Djgreene730/Ad-Flier/altium/images/Flight_Controller_Bottom_Top.png

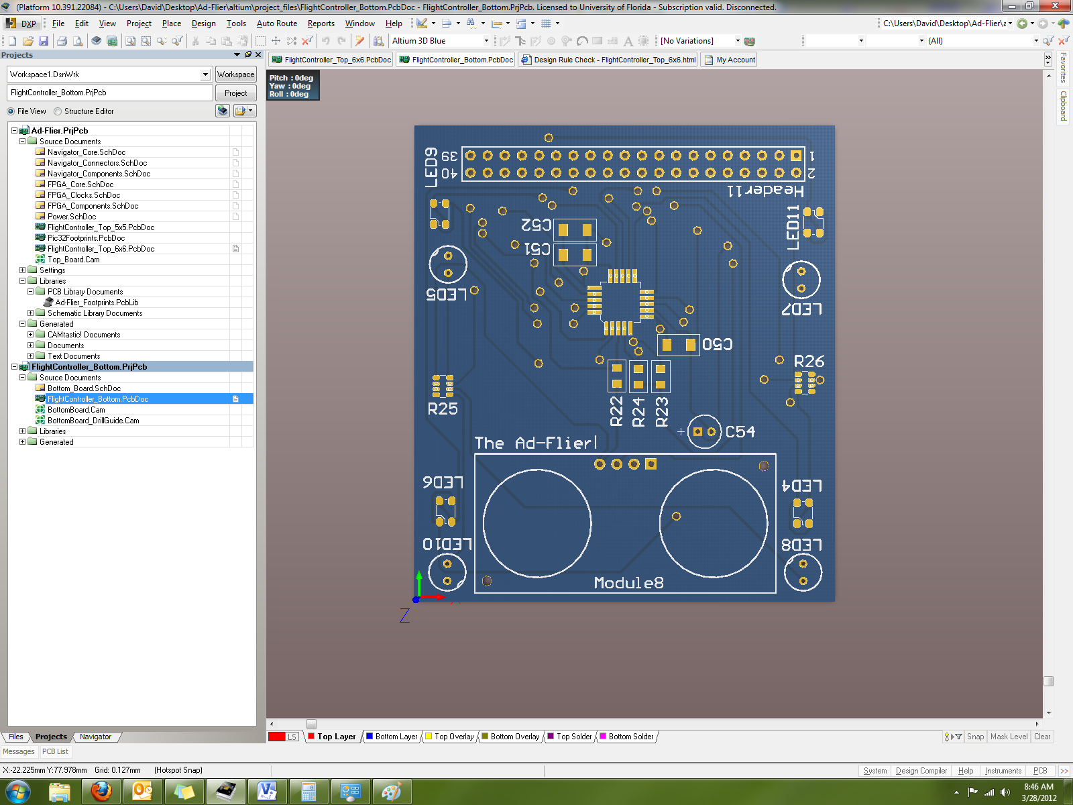
altium/images/Flight_Controller_Bottom_Top.png
