Djgreene730/Ad-Flier/altium/images/Flight_Controller_Top_Top.png

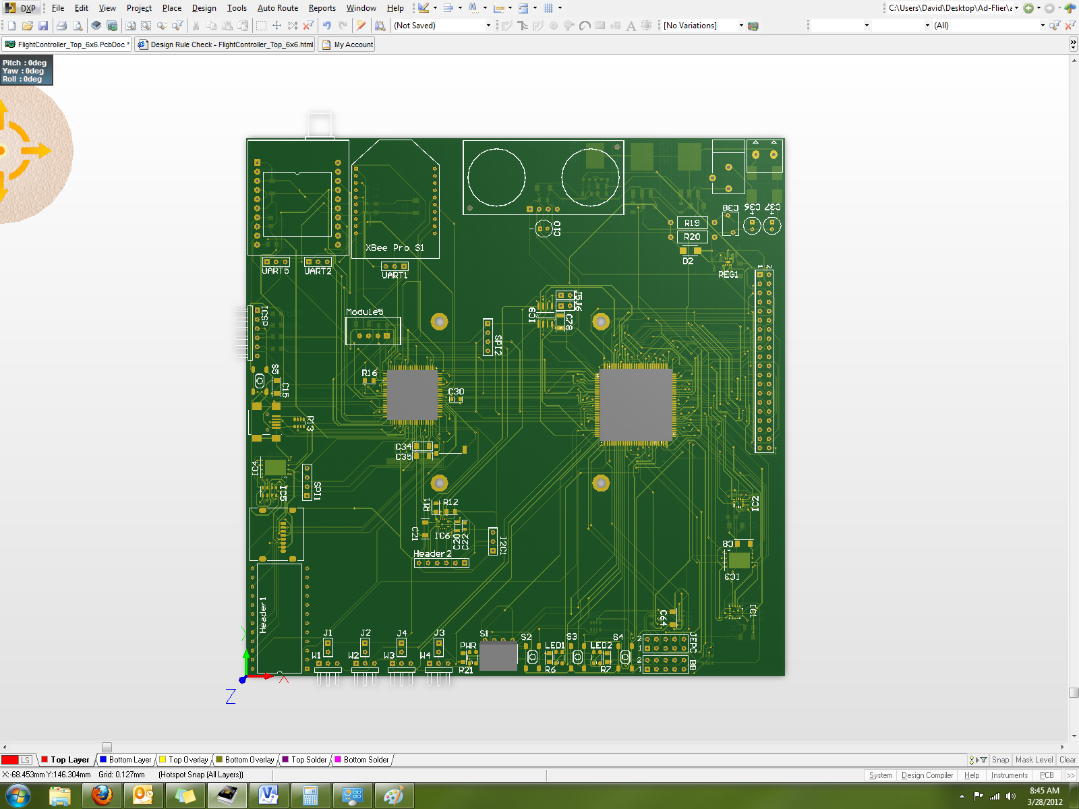
altium/images/Flight_Controller_Top_Top.png
