Djgreene730/Ad-Flier/flowcharts/README

Project: 	Ad-Flier / 
Description:	PIC32 & CycloneII Based Navigation and Stabalization board for UAV's.
Davte:		February 20th, 2012
Authors:	David Greene
		Sal D'Acunto
