Djgreene730/Ad-Flier/altium/README

Project: 	Ad-Flier / Altium Board Files
Description:	PIC32 & CycloneII Based Navigation and Stabalization board for UAV's.
Davte:		February 20th, 2012
Authors:	David Greene
		Sal D'Acunto
