Djgreene730/Ad-Flier/code_windows/README

Project: 	Ad-Flier / Code for the Windows Stats Panel and Interface
Description:	PIC32 & CycloneII Based Navigation and Stabalization board for UAV's.
Davte:		February 20th, 2012
Authors:	David Greene
		Sal D'Acunto
