Djgreene730/Ad-Flier/PIC32_FlightController.X/README

Project: 	Ad-Flier / Code for the PIC32 Flight Control Board
Description:	PIC32 & CycloneII Based Navigation and Stabalization board for UAV's.
Davte:		February 20th, 2012
Authors:	David Greene
		Sal D'Acunto
