Djgreene730/Ad-Flier/altium/images/Accelerometer.jpg

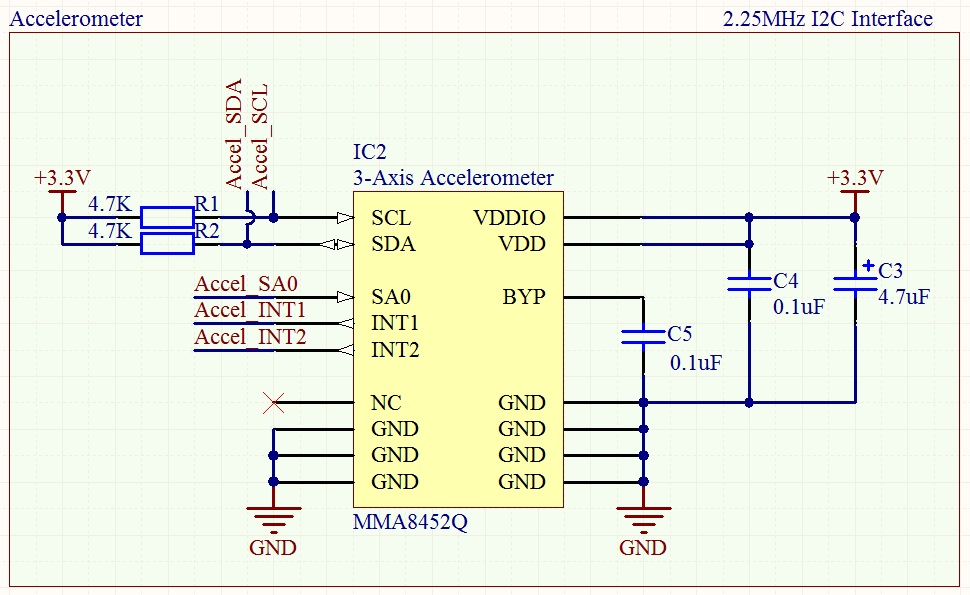
altium/images/Accelerometer.jpg
