Djgreene730/Ad-Flier/altium/images/Flight_Controller_Bottom_Bottom.png

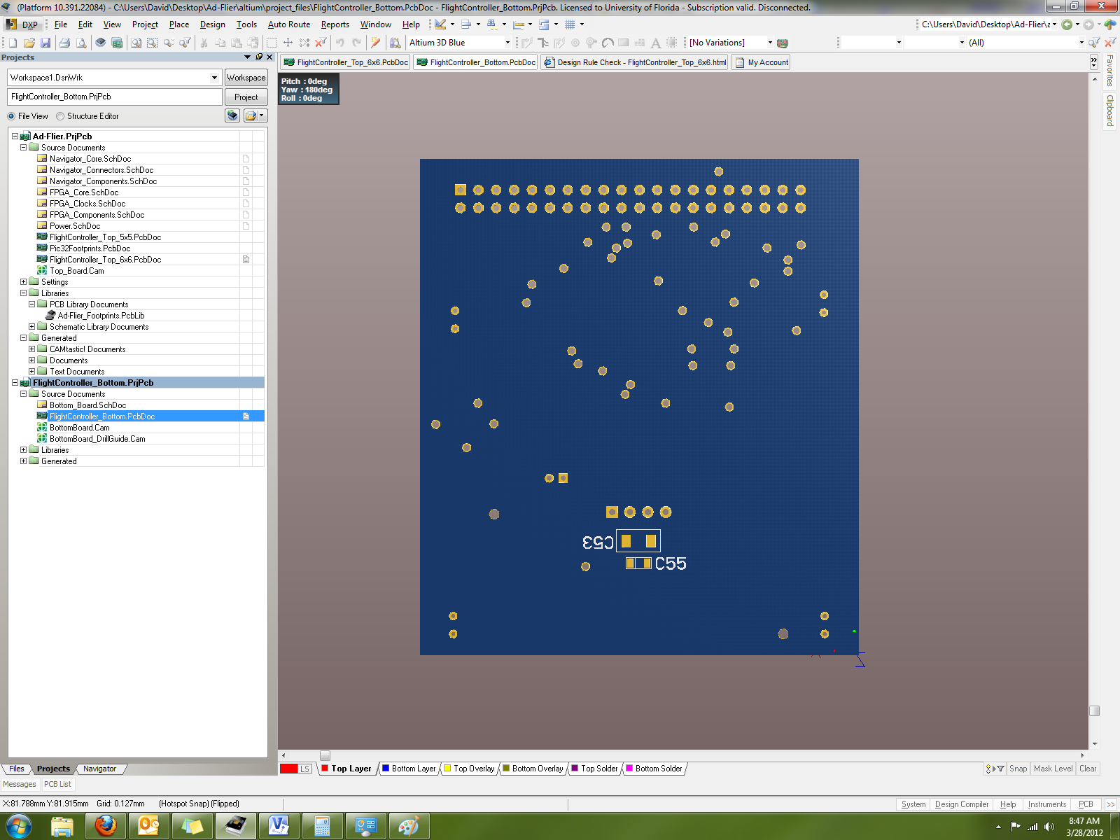
altium/images/Flight_Controller_Bottom_Bottom.png
