Djgreene730/Ad-Flier/altium/images/Flight_Controller_Top_Bottom.png

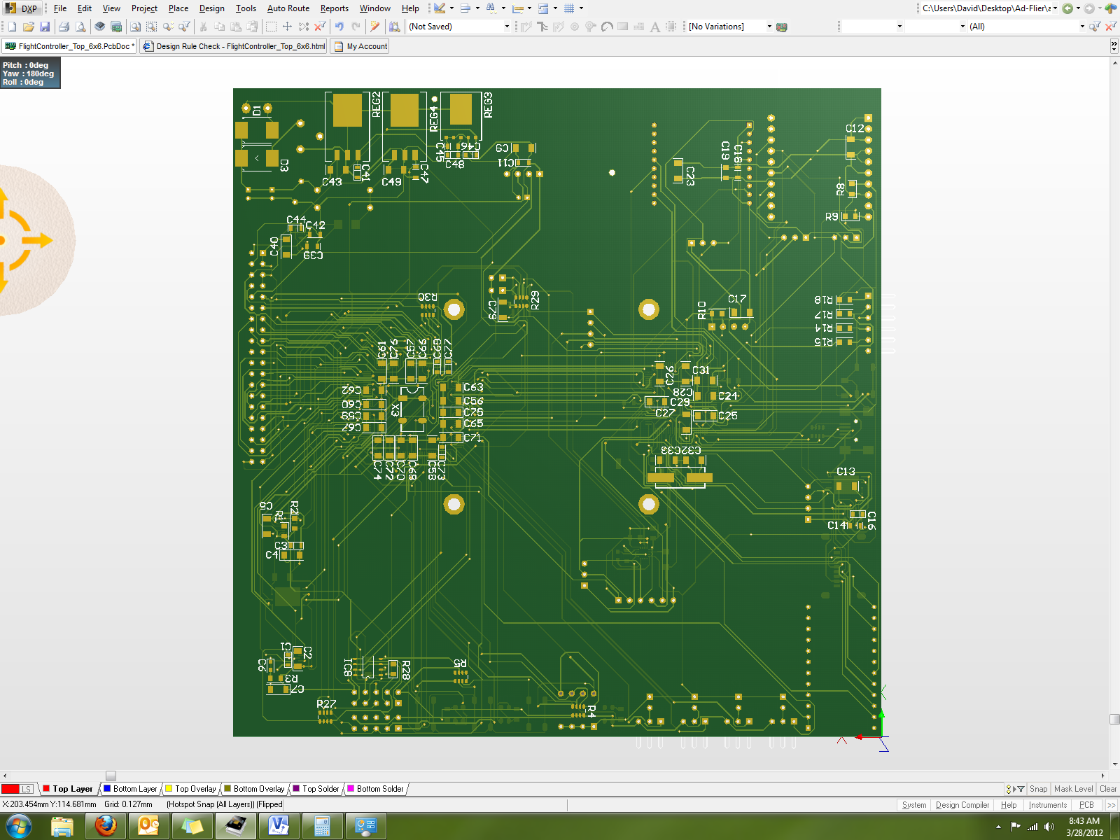
altium/images/Flight_Controller_Top_Bottom.png
