Djgreene730/Ad-Flier/altium/images/Gyroscope.jpg

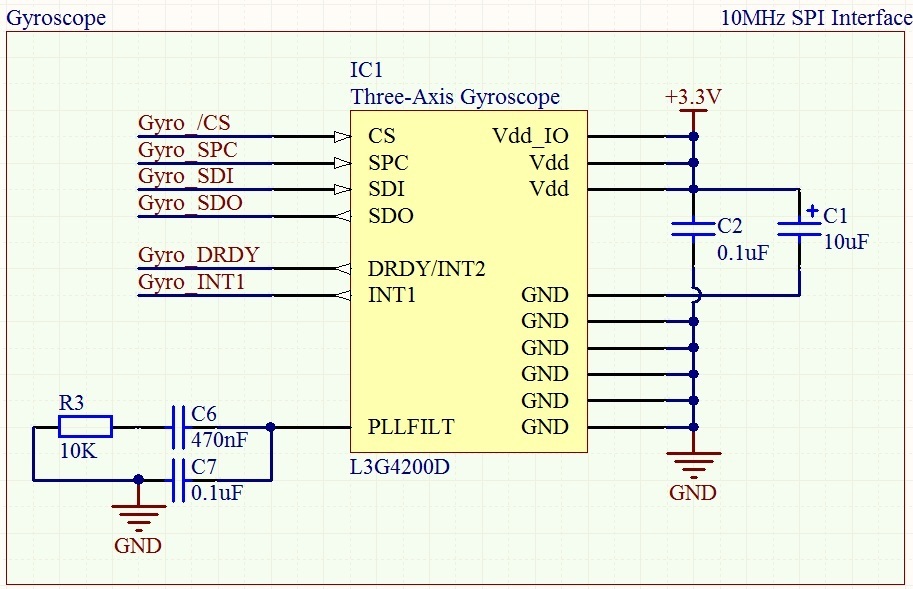
altium/images/Gyroscope.jpg
