Djgreene730/Ad-Flier/altium/project_files/Project Outputs for FlightController_Bottom/BOM_FlightController_Bottom.xlsx

Comment | Description | Designator | Footprint | LibRef | Quantity
0.1uF SMD 1206 | Capacitor | C50, C51, C52, C53 | SMD 1206 | Cap | 4
10uF Electrolitic | Polarized Capacitor (Radial) | C54 | CAPPR2-5x5 | Cap Pol1 | 1
1.0uF Low-ESR Tantalum CaseA | Tantalum Capacitor - Case A | C55 | Capacitor - Tantalum Case A | SMD_Cap_Tantalum | 1
Header 20X2H | Header, 20-Pin, Dual row, Right Angle | Header11 | HDR2X20H | Header 20X2H | 1
LED PLCC-4 | Surface Mount Chip LED | LED4, LED6, LED9, LED11 | PLCC-4 LED | HSMF-C157 | 4
LED Blue Through-Hole | Typical INFRARED GaAs LED | LED5, LED7, LED8, LED10 | Blue LED | LED0 | 4
TCM8230MD | Toshiba 640x480 Camera | Module7 | TCM8230MD Camera Module | TCM8230MD | 1
HC-SR04 Ultrasonic Module | HC-SR04 Ultrasonic Module | Module8 | HC-SR04 Ultrasonic Ranger | HC-SR04 Ultrasonic Module | 1
4.7K SMD 0805 | Resistor | R22, R23, R24 | SMD 0805 | Res2 | 3
Value: 10K SMD Resistor Array | 4-Count Resistor Array | R25, R26 | Resistor Array YC164 | SMD Resistor Array | 2
