Djgreene730/Ad-Flier/altium/project_files/BaseStation/Project Outputs for BaseStation/BaseStation.xlsx

Comment | Description | Designator | Footprint | LibRef | Quantity
Coin Cell Holder | Coin Cell Battery Holder | BATT1 | Coil Cell Holder | Coin Cell Holder | 1
0.1uF SMD 1206 | Capacitor | C1, C2, C3, C4, C5, C6, C8, C13, C15, C16, C23, C25, C27 | SMD 1206 | Cap | 13
10uF Low-ESR Tantalum CaseA | Tantalum Capacitor - Case A | C7, C14, C24, C26 | Capacitor - Tantalum Case A | SMD_Cap_Tantalum | 4
22pF SMD 1206 | Capacitor | C9, C10, C11, C12 | SMD 1206 | Cap | 4
1.0uF Low-ESR Tantalum CaseA | Tantalum Capacitor - Case A | C17, C19, C20, C21 | Capacitor - Tantalum Case A | SMD_Cap_Tantalum | 4
8.2pF SMD 0805 | Capacitor | C18 | SMD 0805 | Cap | 1
10uF Electrolitic | Polarized Capacitor (Radial) | C22 | CAPPR2-5x5 | Cap Pol1 | 1
MBRS540T3G | 40V 5A Scottky Diode | D1, D3 | MBRS540T3G | MBRS540T3G | 2
1SMAS913BT3G | 3.3V 1.5W Zener Diode | D2 | 1SMA5913BT3G | 1SMAS913BT3G | 1
SPI1 | Header, 4-Pin | Debug1, Debug2 | HDR1X4 | Header 4 | 2
UART1 | Header, 3-Pin | Debug3 | HDR1X3 | Header 3 | 1
UART2 | Header, 3-Pin | Debug4 | HDR1X3 | Header 3 | 1
UART5 | Header, 3-Pin | Debug5 | HDR1X3 | Header 3 | 1
Battery |  | H1 | PC Wire Connector | PC Wire Connector | 1
7-12V | DC Power Jack | H2 | DC Power Jack | DC Jack | 1
ICSP | Header, 6-Pin | Header 1 | HDR1X6H | Header 6 | 1
PIC32MX795F512L-80I/PT | High Performance 80 MHz MIPS-Based 32-Bit Flash Microcontroller with USB, CAN and Ethernet, 512KB Program Memory, 100-pin TQFP, Industrial Temperature | IC1 | TQFP-PF100_L | PIC32MX795F512L-80I/PT | 1
MPL115A1 | Miniature SPI Digital Barometer | IC2 | MPL115A1 | MPL115A1 | 1
GPS Select | Header, 4-Pin, Dual row | J1 | HDR2X4 | Header 4X2 | 1
Link |  | LED1 | PLCC-4 LED | SMD LED | 1
ON | Surface Mount Chip LED | LED2 | PLCC-4 LED | SMD LED | 1
Mini-USB | Mini-USB | Module1 | Mini B USB Connector | Mini USB Connector | 1
Trimble 37824-B | Trimble 37824-B GPS Module | Module2 | Trimble 37824-B | Trimble 37824-B | 1
Bluetooth | Bluetooth SMD Serial Module | Module3 | BT0417C Bluetooth Module | Bluetooth SMD Module | 1
XBee Pro S1 | XBee Pro S1 60mW Wireless Module | Module4 | XBee Pro S1 Wireless Module | XBee Pro S1 | 1
MicroSD | MicroSD SPI Interface | Module5 | MicroSD Card Slot | MicroSD Socket | 1
PS2 Controller | PS2 Wireless Controller | Module6 | PS2 Wireless Module | PS2 Wireless Controller | 1
Header 2 | Header, 2-Pin | P1, P2, P3 | HDR1X2 | Header 2 | 3
10 SMD 0805 | Resistor | R1 | SMD 0805 | Res2 | 1
10K SMD 0805 | Resistor | R2, R7, R8, R9 | SMD 0805 | Res2 | 4
100 SMD 0805 | Resistor | R3, R5, R6 | SMD 0805 | Res2 | 3
Value: 10K SMD Resistor Array | 4-Count Resistor Array | R4, RA1 | Resistor Array YC164 | SMD Resistor Array | 2
1K SMD 0805 | Resistor | R10, R11, R14 | SMD 0805 | Res2 | 3
3.9K Radial | Resistor | R12 | RES12.2-8.5X3.3 | Res2 | 1
1.3K Radial | Resistor | R13 | RES12.2-8.5X3.3 | Res2 | 1
MIC29300-5.0WU | 3.0A LDO Fixed Volt.(ROHS Compliant) | REG1 | TO-263 D2PACK | MIC29300-5.0WU | 1
MIC29300-3.3WU | 3.0A LDO Fixed Volt.(ROHS Compliant) | REG2 | TO-263 D2PACK | MIC29300-3.3WU | 1
Reset | SMD Tactile Switch | S1 | SMD Tactile Switch | SMD Tactile Switch | 1
Key | SMD Tactile Switch | S2 | SMD Tactile Switch | SMD Tactile Switch | 1
XT9M20ANA8M | 8MHz SMD Crystal | X1 | XT9M20ANA8M - 8MHz Capacitor | XT9M20ANA8M | 1
SSP-T6-7PF-20PPM | 32.768KHz 7pF SMD Crystal | X2 | 32.768KHz Crystal | SSP-T6-7PF-20PPM | 1
