Djgreene730/Ad-Flier/code_cyclone2/BoardTest/BoardTest/TestSPI/TestSPI.html

TestSPI | TestSPI 1.0

2012.04.14.18:18:51 | Generation Report

Output Directory | C:/Users/David/GitHub/Ad-Flier/code_cyclone2/BoardTest/TestSPI/

Files

C:/Users/David/GitHub/Ad-Flier/code_cyclone2/BoardTest/TestSPI/synthesis/TestSPI.v (2964 bytes VERILOG)

C:/Users/David/GitHub/Ad-Flier/code_cyclone2/BoardTest/TestSPI/synthesis/submodules/TestSPI_spi_0.v (12263 bytes VERILOG)
C:/Users/David/GitHub/Ad-Flier/code_cyclone2/BoardTest/TestSPI/synthesis/submodules/altera_reset_controller.v (3595 bytes VERILOG)
C:/Users/David/GitHub/Ad-Flier/code_cyclone2/BoardTest/TestSPI/synthesis/submodules/altera_reset_synchronizer.v (3564 bytes VERILOG)
C:/Users/David/GitHub/Ad-Flier/code_cyclone2/BoardTest/TestSPI/synthesis/submodules/altera_reset_controller.sdc (1179 bytes SDC)
Instantiations

TestSPI TestSPI v1.0 | TestSPI_spi_0 as spi_0 altera_reset_controller as rst_controller
TestSPI_spi_0 altera_avalon_spi v11.1
altera_reset_controller altera_reset_controller v11.1

Generation Messages

2012.04.14.18:16:35 [Warning] TestSPI.spi_0: spi_0.external must be exported, or connected to a matching conduit. 2012.04.14.18:16:35 [Warning] TestSPI.spi_0: spi_0.spi_control_port must be connected to an Avalon-MM master 2012.04.14.18:16:35 [Warning] TestSPI.spi_0: Interrupt sender spi_0.irq is not connected to an interrupt receiver 2012.04.14.18:16:35 [Info] TestSPI: Generating TestSPI "TestSPI" for QUARTUS_SYNTH 2012.04.14.18:16:35 [Debug] TestSPI: queue size: 0 starting:TestSPI "TestSPI" 2012.04.14.18:16:36 [Debug] Transform: PipelineBridgeSwap 2012.04.14.18:16:36 [Info] pipeline_bridge_swap_transform: After transform: 2 modules, 2 connections 2012.04.14.18:16:36 [Debug] Transform: ClockCrossingBridgeSwap 2012.04.14.18:16:36 [Debug] Transform: QsysBetaIPSwap 2012.04.14.18:16:36 [Debug] Transform: CustomInstructionTransform 2012.04.14.18:16:36 [Info] No custom instruction connections, skipping transform 2012.04.14.18:16:36 [Debug] Transform: TristateConduitUpgradeTransform 2012.04.14.18:16:36 [Debug] Transform: TranslatorTransform 2012.04.14.18:16:36 [Info] No Avalon connections, skipping transform 2012.04.14.18:16:36 [Debug] Transform: DomainTransform 2012.04.14.18:16:36 [Debug] Transform: RouterTransform 2012.04.14.18:16:36 [Debug] Transform: TrafficLimiterTransform 2012.04.14.18:16:36 [Debug] Transform: BurstTransform 2012.04.14.18:16:36 [Debug] Transform: ResetAdaptation 2012.04.14.18:16:36 [Progress] min: 0 2012.04.14.18:16:36 [Progress] max: 1 2012.04.14.18:16:36 [Progress] current: 1 2012.04.14.18:16:36 [Info] reset_adaptation_transform: After transform: 3 modules, 4 connections 2012.04.14.18:16:36 [Debug] Transform: NetworkToSwitchTransform 2012.04.14.18:16:36 [Debug] Transform: WidthTransform 2012.04.14.18:16:36 [Debug] Transform: RouterTableTransform 2012.04.14.18:16:36 [Debug] Transform: ClockCrossingTransform 2012.04.14.18:16:36 [Debug] Transform: PipelineTransform 2012.04.14.18:16:36 [Debug] Transform: TrafficLimiterUpdateTransform 2012.04.14.18:16:36 [Debug] Transform: InterruptMapperTransform 2012.04.14.18:16:36 [Debug] Transform: InterruptSyncTransform 2012.04.14.18:16:36 [Debug] Transform: InterruptFanoutTransform 2012.04.14.18:16:36 [Debug] TestSPI: "TestSPI" reuses altera_avalon_spi "submodules/TestSPI_spi_0" 2012.04.14.18:16:36 [Debug] TestSPI: "TestSPI" reuses altera_reset_controller "submodules/altera_reset_controller" 2012.04.14.18:16:37 [Debug] TestSPI: queue size: 1 starting:altera_avalon_spi "submodules/TestSPI_spi_0" 2012.04.14.18:16:38 [Info] Starting classic module elaboration. 2012.04.14.18:17:37 [Progress] "c:/altera/11.1sp1/quartus/bin/jre/bin/java.exe" -Xmx512M -classpath "c:/altera/11.1sp1/quartus/sopc_builder/bin/sopc_builder.jar;c:/altera/11.1sp1/quartus/sopc_builder/bin/PinAssigner.jar;c:/altera/11.1sp1/quartus/sopc_builder/bin/sopc_wizard.jar;c:/altera/11.1sp1/quartus/sopc_builder/bin/jptf.jar" sopc_builder.sopc_builder -d"c:/altera/11.1sp1/quartus/sopc_builder" -notalkback=1 -projectnameyysystem.qpf -projectpathC:/Users/David/AppData/Local/Temp/alt5444_3243432175891964107.dir/0001_sopclgen --no_splash --refresh C:/Users/David/AppData/Local/Temp/alt5444_3243432175891964107.dir/0001_sopclgen/yysystem.v --quartus_dir="c:/altera/11.1sp1/quartus" --sopc_perl="c:/altera/11.1sp1/quartus/bin/perl" --sopc_lib_path="++c:/altera/11.1sp1/quartus/../ip/altera/sopc_builder_ip+c:/altera/11.1sp1/quartus/../ip/altera/nios2_ip" 2012.04.14.18:17:44 [Info] Finished elaborating classic module. 2012.04.14.18:17:44 [Progress] Executing: C:/altera/11.1sp1/quartus//sopc_builder/bin/sopc_builder --classic --generate C:/Users/David/AppData/Local/Temp/alt5444_3243432175891964107.dir/0001_sopclgen/yysystem.ptf 2012.04.14.18:17:44 [Info] Running sopc_builder... 2012.04.14.18:18:41 [Progress] "c:/altera/11.1sp1/quartus/bin/jre/bin/java.exe" -Xmx512M -classpath "c:/altera/11.1sp1/quartus/sopc_builder/bin/sopc_builder.jar;c:/altera/11.1sp1/quartus/sopc_builder/bin/PinAssigner.jar;c:/altera/11.1sp1/quartus/sopc_builder/bin/sopc_wizard.jar;c:/altera/11.1sp1/quartus/sopc_builder/bin/jptf.jar" sopc_builder.sopc_builder -d"c:/altera/11.1sp1/quartus/sopc_builder" -notalkback=1 -projectnameyysystem.qpf -projectpathC:/Users/David/AppData/Local/Temp/alt5444_3243432175891964107.dir/0001_sopclgen --generate C:/Users/David/AppData/Local/Temp/alt5444_3243432175891964107.dir/0001_sopclgen/yysystem.v --quartus_dir="c:/altera/11.1sp1/quartus" --sopc_perl="c:/altera/11.1sp1/quartus/bin/perl" --sopc_lib_path="++c:/altera/11.1sp1/quartus/../ip/altera/sopc_builder_ip+c:/altera/11.1sp1/quartus/../ip/altera/nios2_ip" 2012.04.14.18:18:47 [Progress] No .sopc_builder configuration file(!) 2012.04.14.18:18:47 [Progress] . 2012.04.14.18:18:50 [Progress] # 2012.04.14 18:18:50 (*) Success: sopc_builder finished. 2012.04.14.18:18:51 [Info] spi_0: "TestSPI" instantiated altera_avalon_spi "spi_0" 2012.04.14.18:18:51 [Debug] TestSPI: queue size: 0 starting:altera_reset_controller "submodules/altera_reset_controller" 2012.04.14.18:18:51 [Info] rst_controller: "TestSPI" instantiated altera_reset_controller "rst_controller" 2012.04.14.18:18:51 [Info] TestSPI: Done TestSPI" with 3 modules, 5 files, 23565 bytes
