Djgreene730/Ad-Flier/flowcharts/Overview-InProgress.vsd.pdf

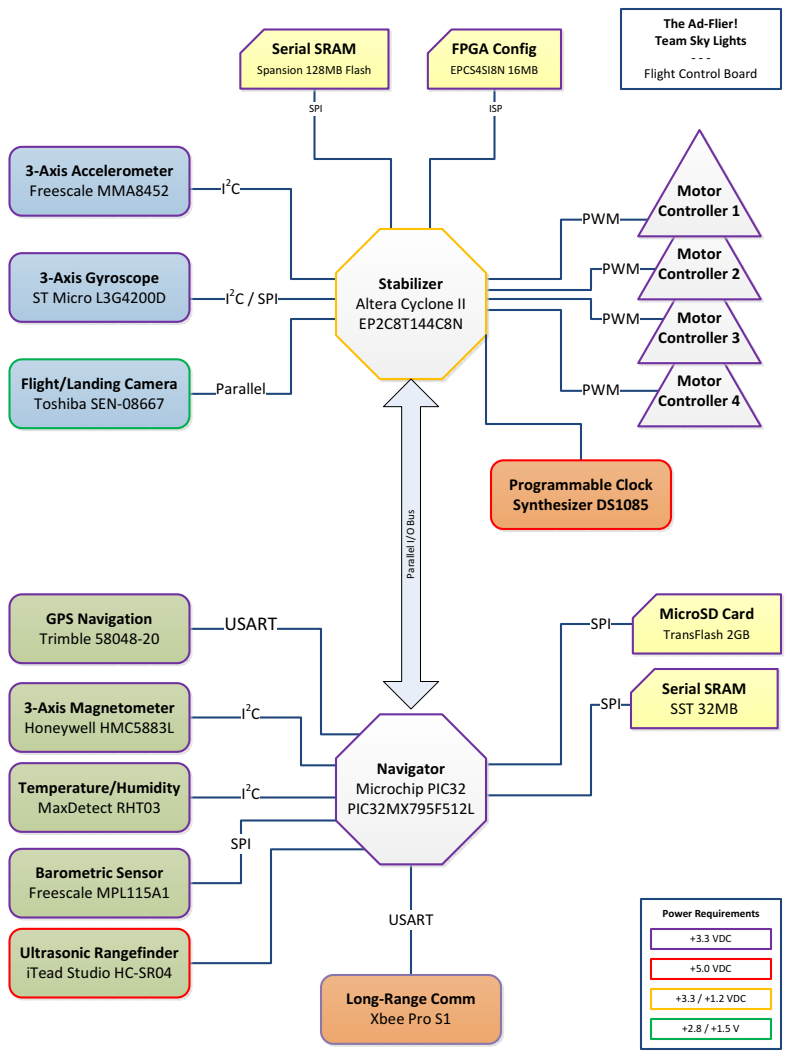
[picture p7: page 1]
Power Requirements; USART; SPI; ISP; 2 C / SPI; Parallel; PWM; Stabilizer Altera Cyclone II EP2C8T144C8N; MicroSD Card; TransFlash 2GB; Barometric Sensor Freescale MPL115A1; 3-Axis Magnetometer Honeywell HMC5883L; Motor Controller 4; Motor Controller 3; 3-Axis Gyroscope ST Micro L3G4200D; 3-Axis Accelerometer Freescale MMA8452; Temperature/Humidity MaxDetect RHT03; GPS Navigation Trimble 58048-20; Motor Controller 2; Motor Controller 1; FPGA Config; EPCS4SI8N 16MB; Parallel I/O Bus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

The Ad-Flier!
Team Sky Lights

Flight Control Board

Flight/Landing Camera
Toshiba SEN-08667

Ultrasonic Rangefinder
iTead Studio HC-SR04

Long-Range Comm
Xbee Pro S1

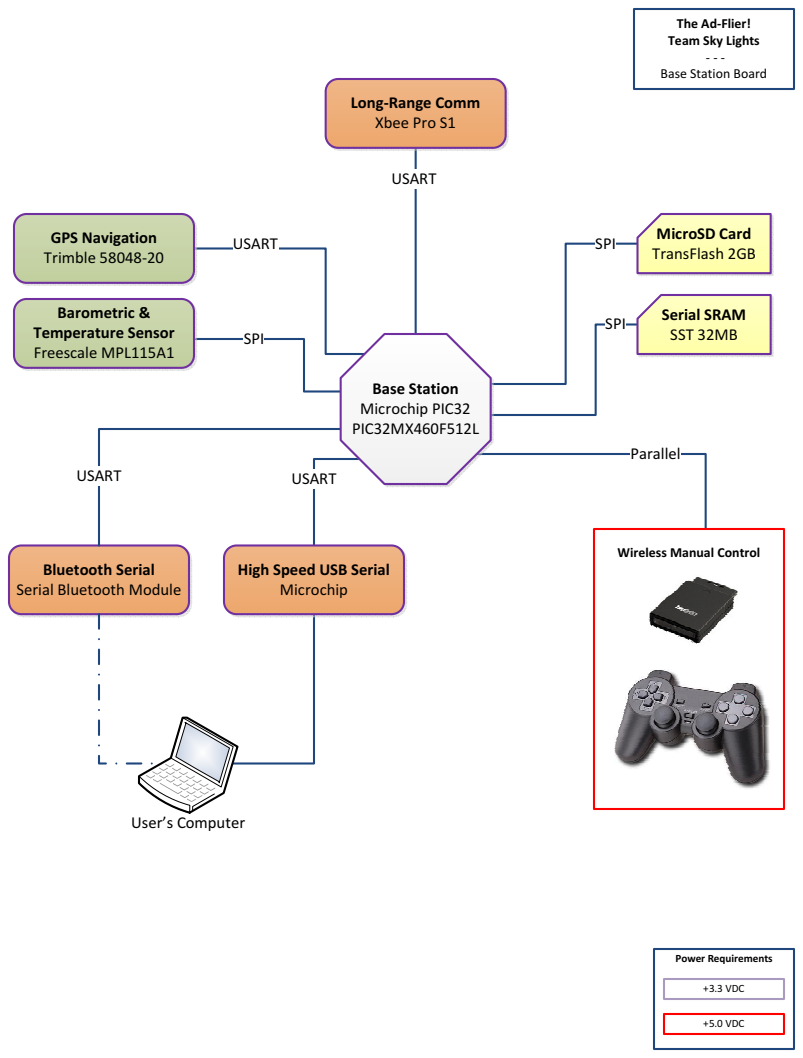
[picture p8: page 2]
Parallel; USART; SPI; MicroSD Card TransFlash 2GB; Serial SRAM SST 32MB; Barometric & Temperature Sensor Freescale MPL115A1; GPS Navigation Trimble 58048-20; Base Station Microchip PIC32 PIC32MX460F512L; User’s Computer; Power Requirements; +5.0 VDC; +3.3 VDC

The Ad-Flier!
Team Sky Lights

Base Station Board

Long-Range Comm
Xbee Pro S1

Wireless Manual Control

Bluetooth Serial | | High Speed USB Serial

Serial Bluetooth Module

Microchip
