Djgreene730/Ad-Flier/altium/project_files/Ad-Flier.pdf

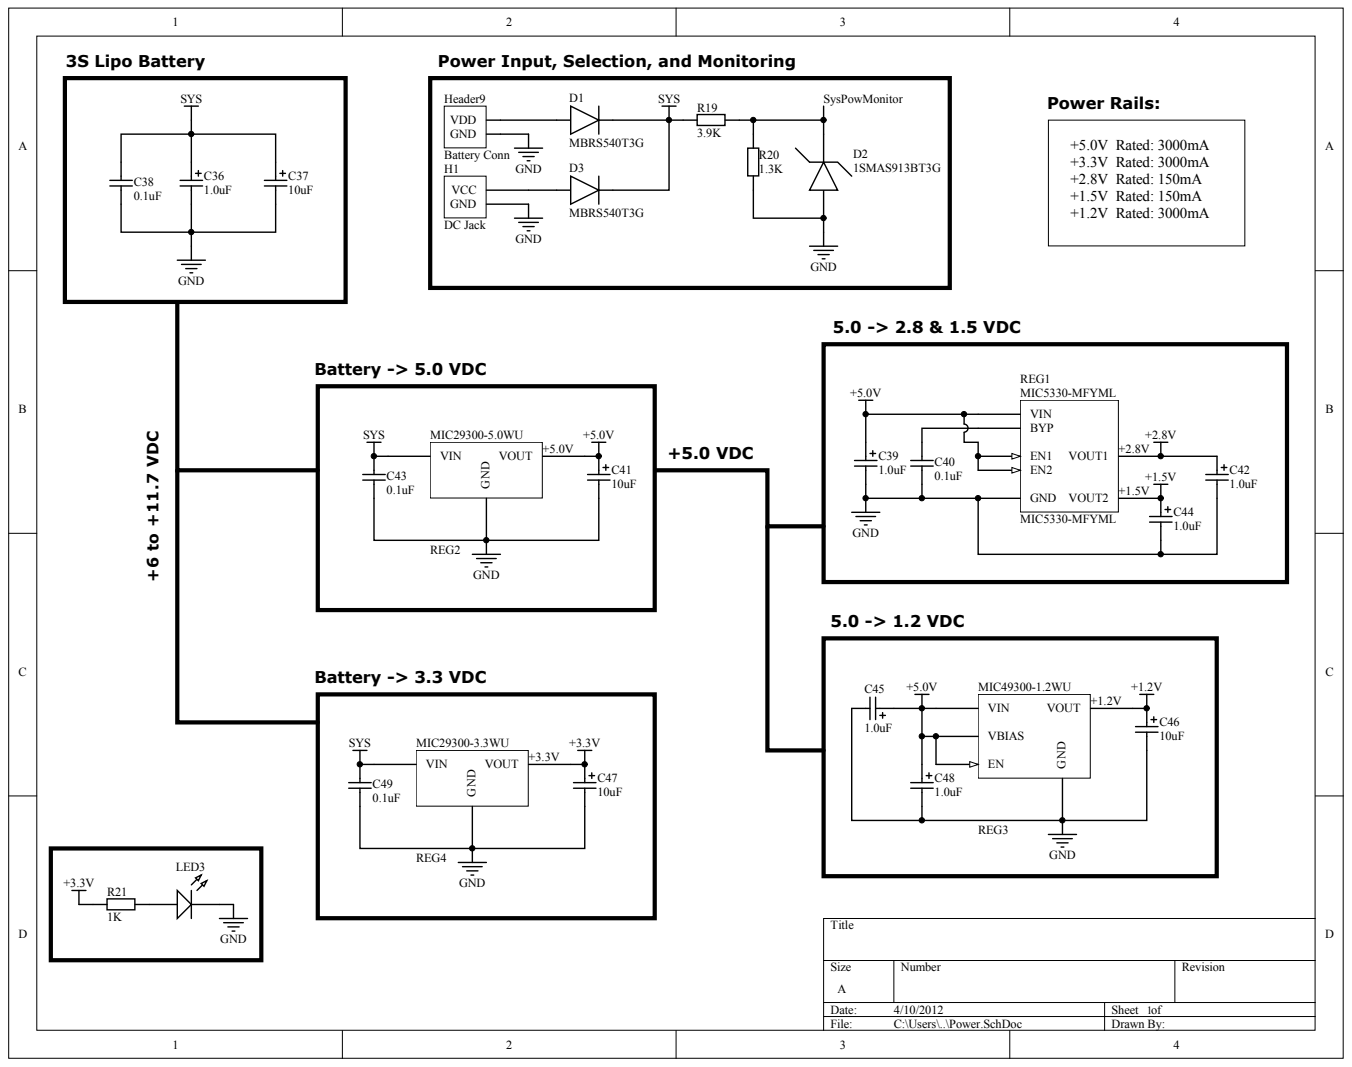
[picture p9: page 1]

Power Input, Selection, and Monitoring

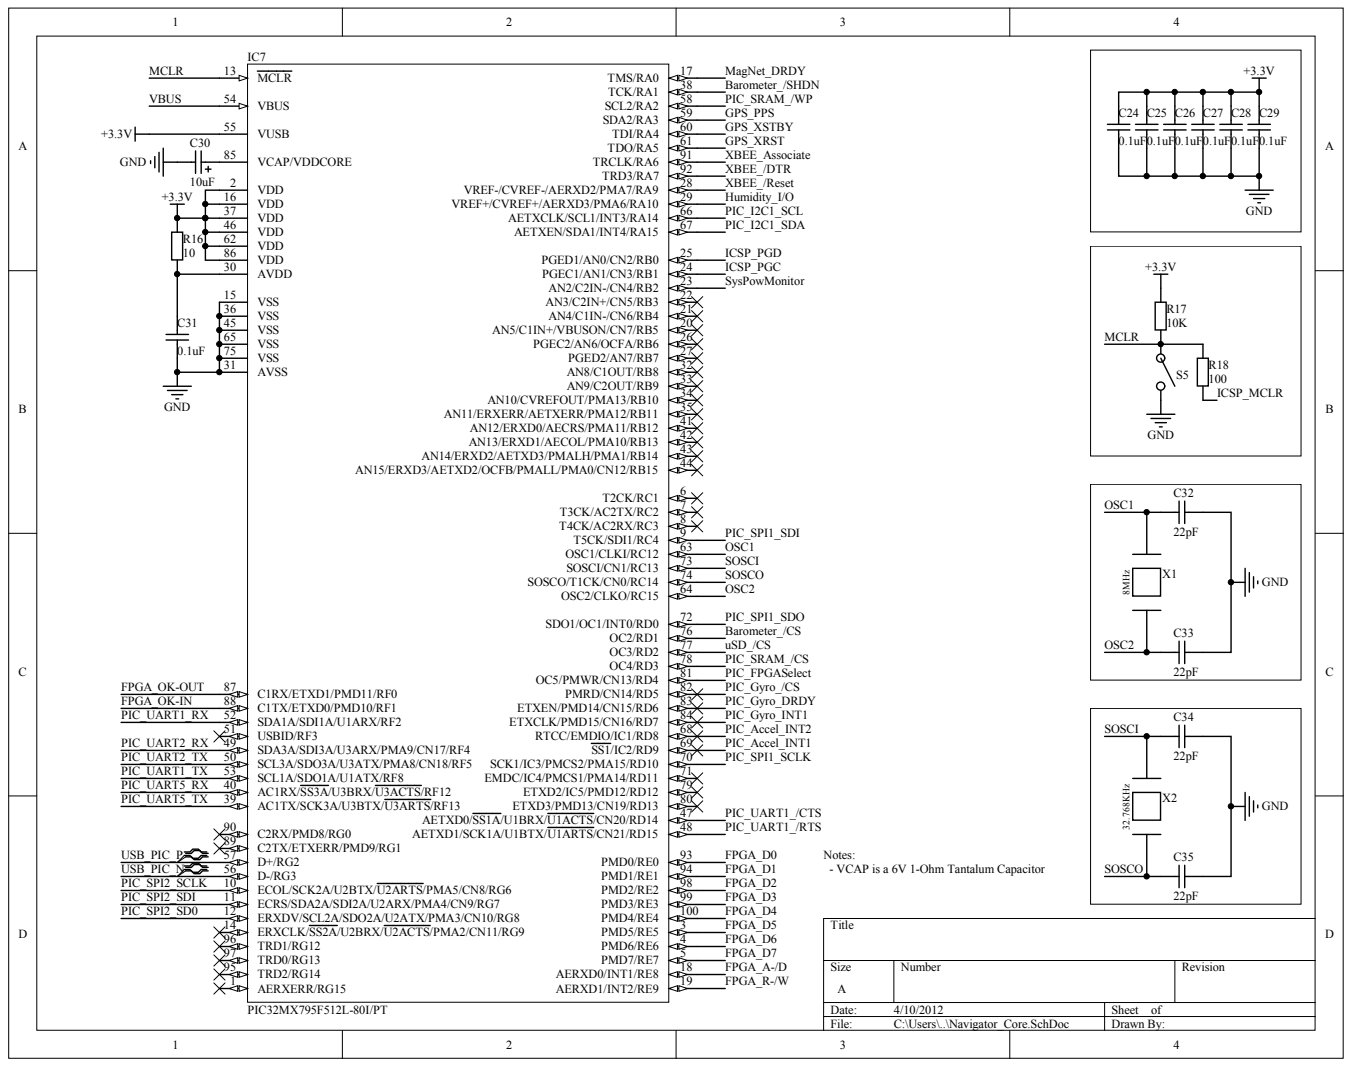
[picture p10: page 2]

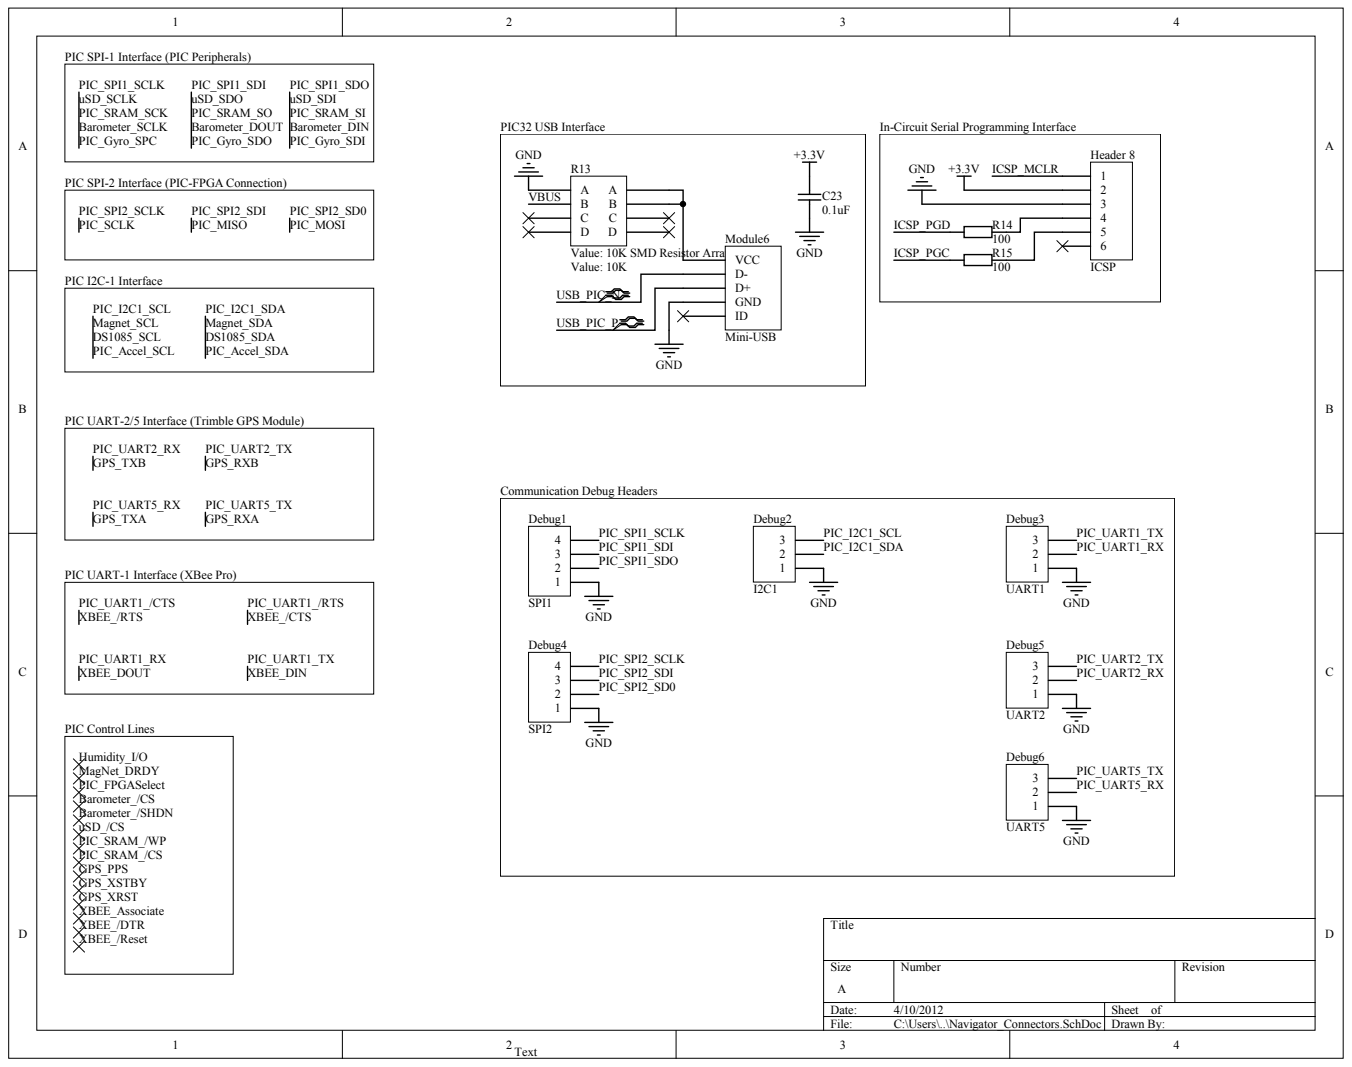
[picture p11: page 3]

PIC SPI-1 Interface (PIC Peripherals)

PIC SPI-2 Interface (PIC-FPGA Connection)

Value: 10K SMD Resistor Array
Value: 10K

PIC UART-2/5 Interface (Trimble GPS Module)

PIC UART-1 Interface (XBee Pro)

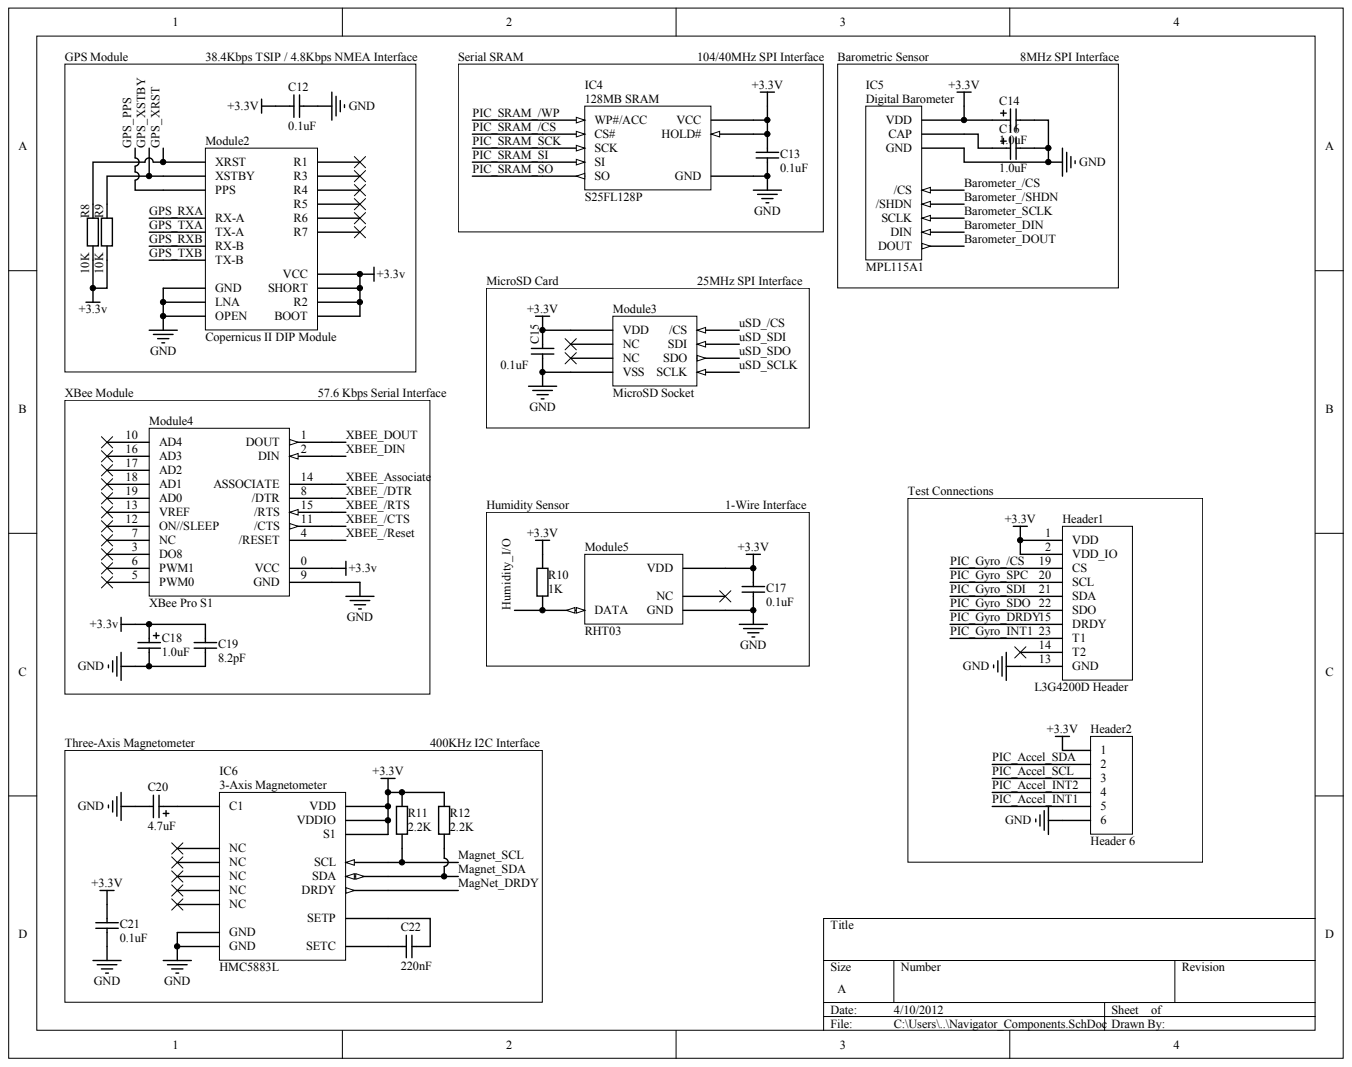
[picture p12: page 4]

Copernicus II DIP Module

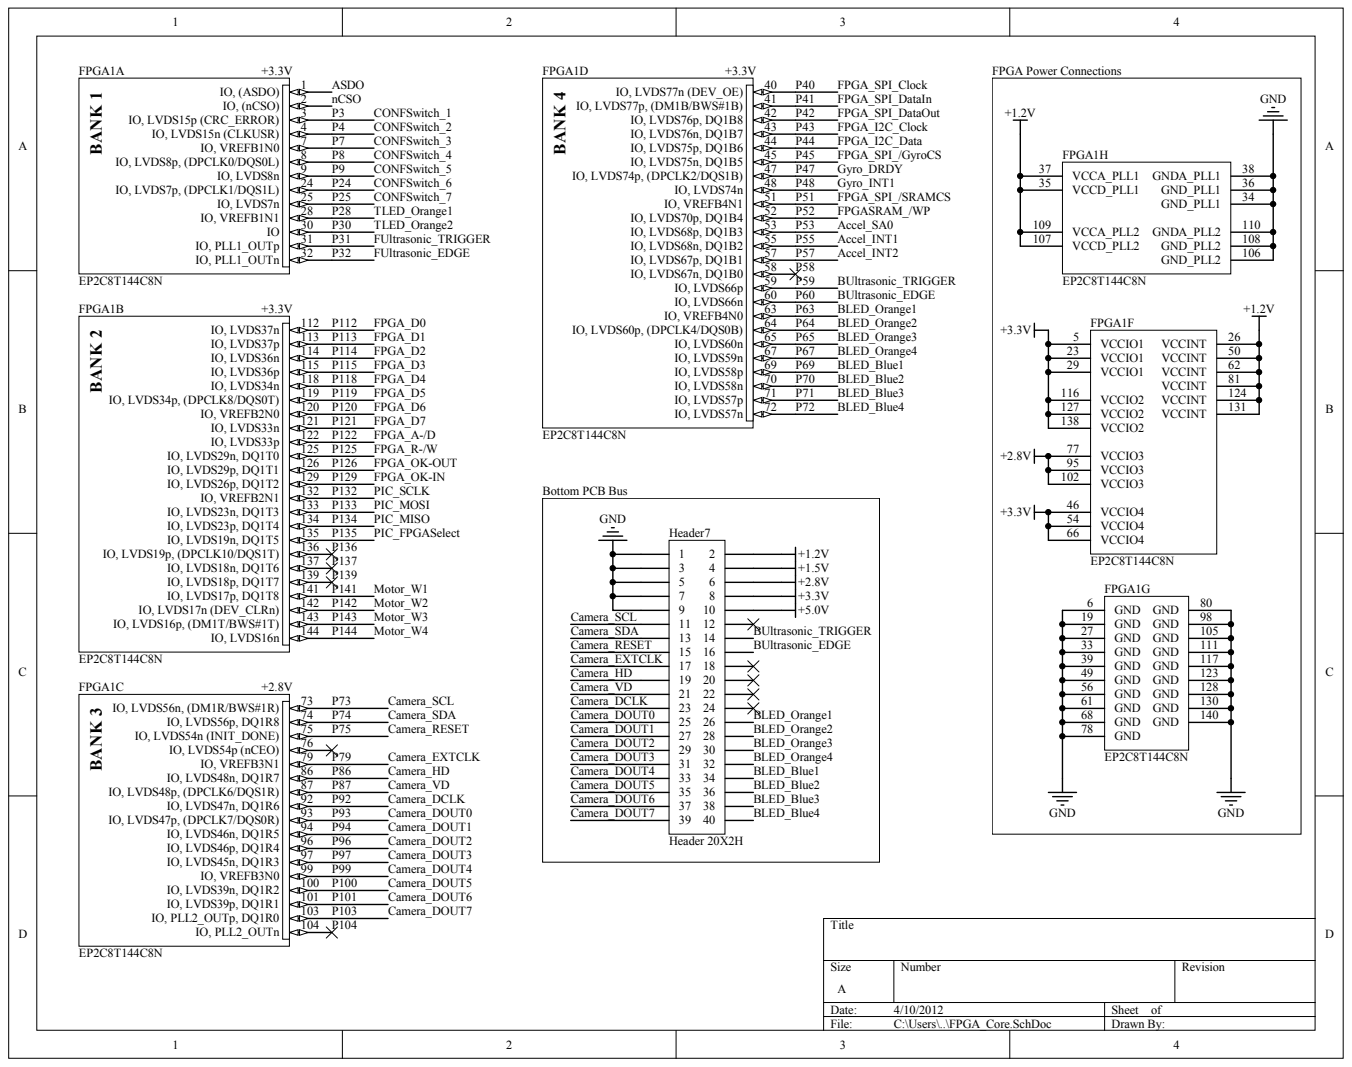
[picture p13: page 5]

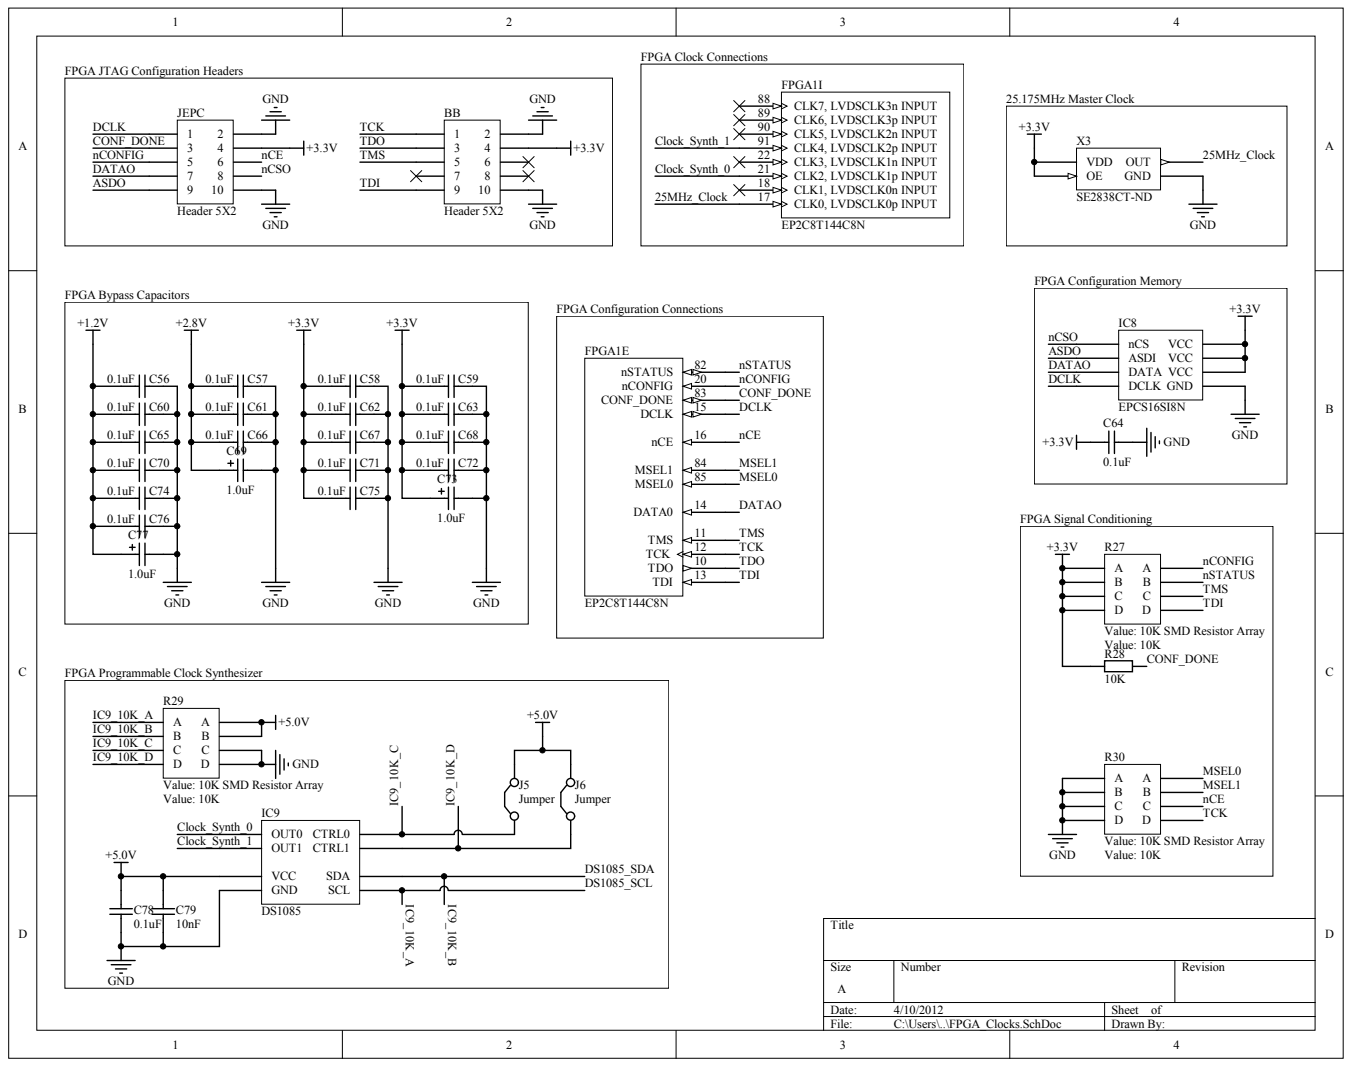
[picture p14: page 6]

FPGA JTAG Configuration Headers

FPGA Programmable Clock Synthesizer

Value: 10K SMD Resistor Array
Value: 10K

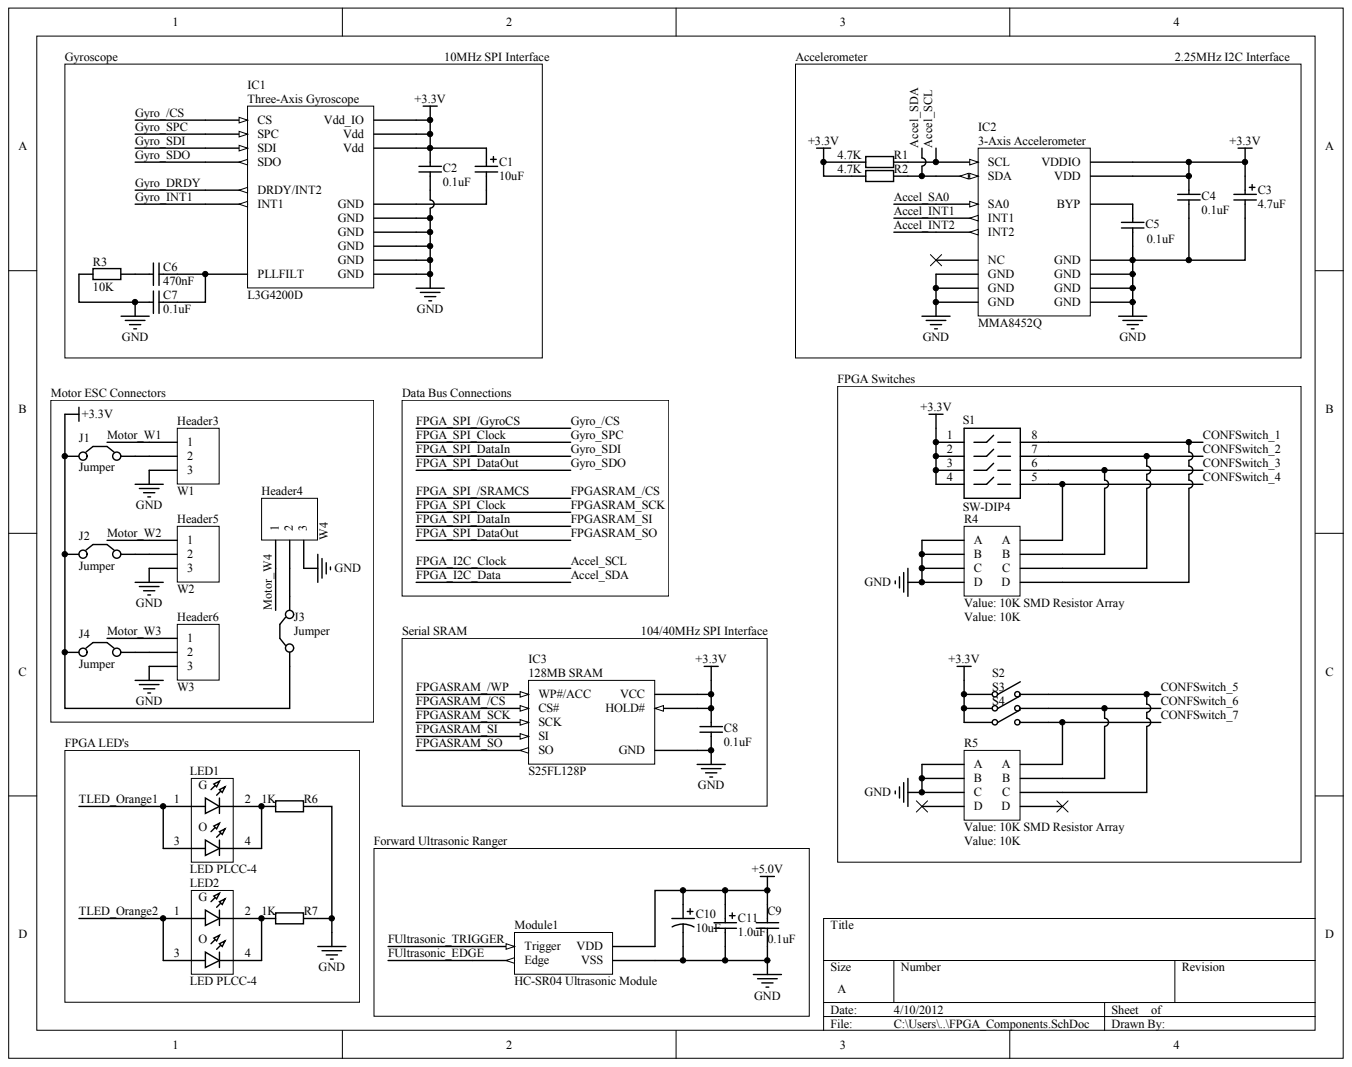
[picture p15: page 7]

Value: 10K SMD Resistor Array
Value: 10K
