Djgreene730/Ad-Flier/altium/project_files/FlightController_Bottom.pdf

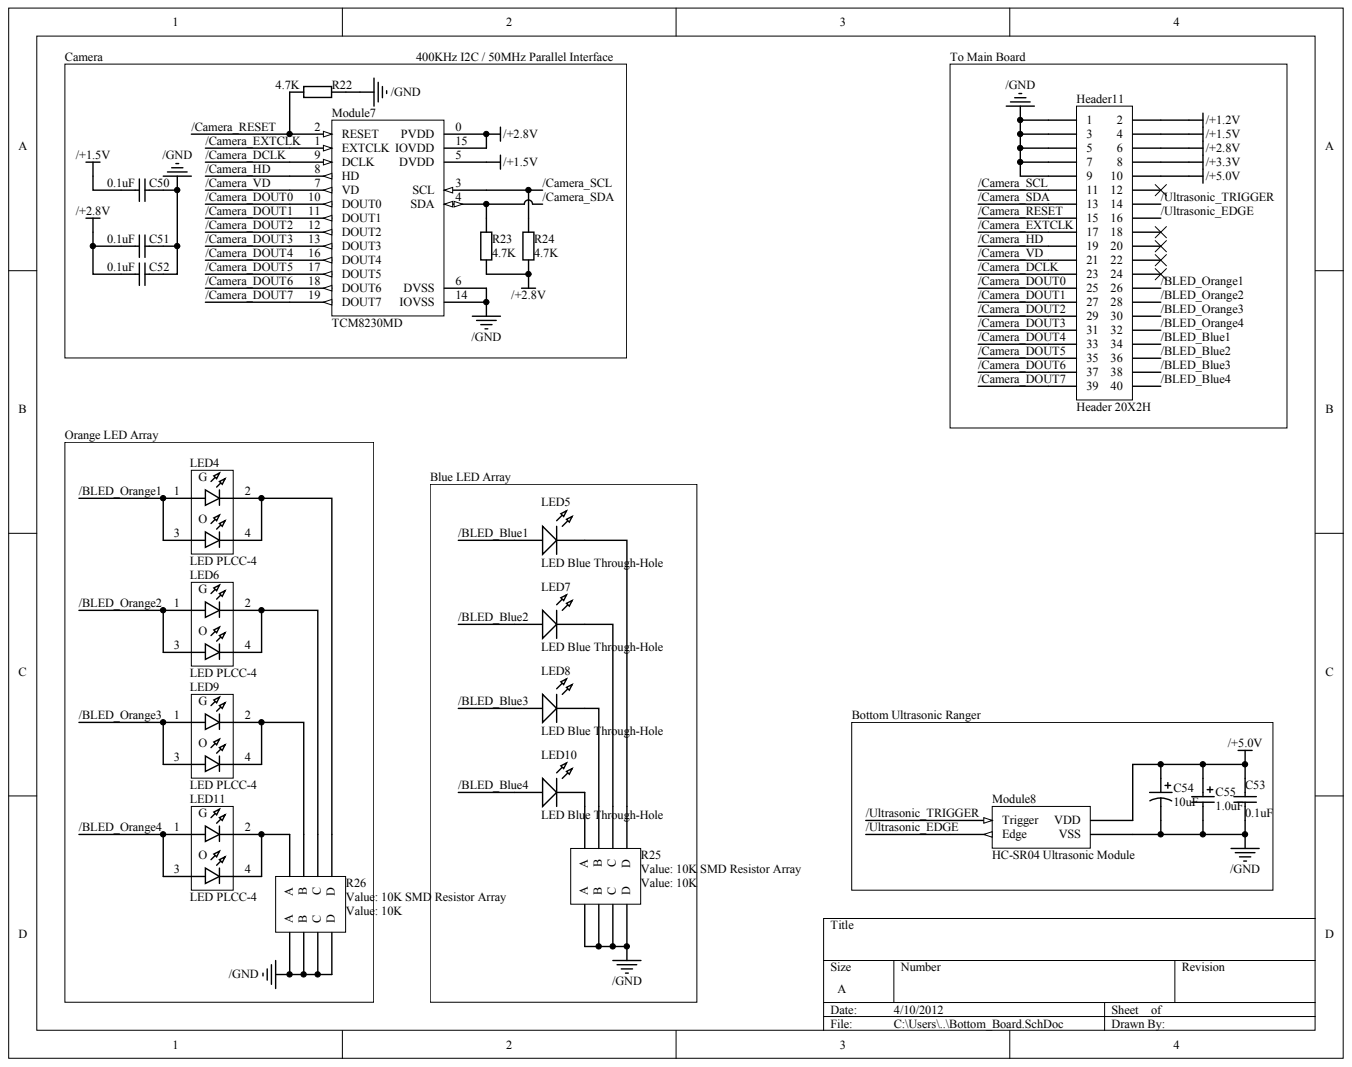
[picture p16: page 1]

LED Blue Through-Hole
