Djgreene730/Ad-Flier/flowcharts/Software/D'Acunto_Greene.pdf

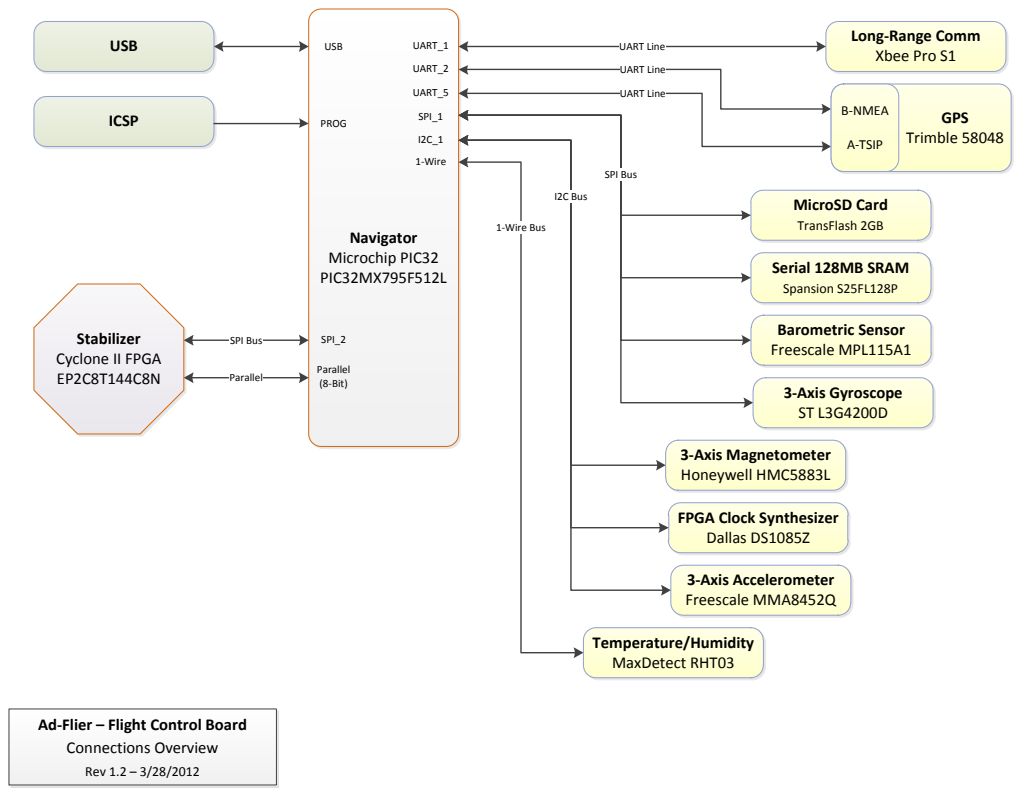
[picture p17: page 1]
Temperature/Humidity MaxDetect RHT03; Stabilizer Cyclone II FPGA EP2C8T144C8N; Navigator Microchip PIC32 PIC32MX795F512L; USB; ICSP; SPI Bus; Parallel; UART Line; MicroSD Card; TransFlash 2GB; Serial 128MB SRAM; Spansion S25FL128P; 3-Axis Magnetometer Honeywell HMC5883L; Barometric Sensor Freescale MPL115A1; 3-Axis Accelerometer Freescale MMA8452Q; 3-Axis Gyroscope ST L3G4200D; UART_1; UART_2; UART_5; SPI_1; 1-Wire; PROG; SPI_2; Parallel (8-Bit); GPS Trimble 58048; B-NMEA; A-TSIP

Long-Range Comm
Xbee Pro S1

UART Line

SPI Bus I2C Bus 1-Wire Bus

FPGA Clock Synthesizer
Dallas DS1085Z

Ad-Flier – Flight Control Board
Connections Overview
Rev 1.2 – 3/28/2012

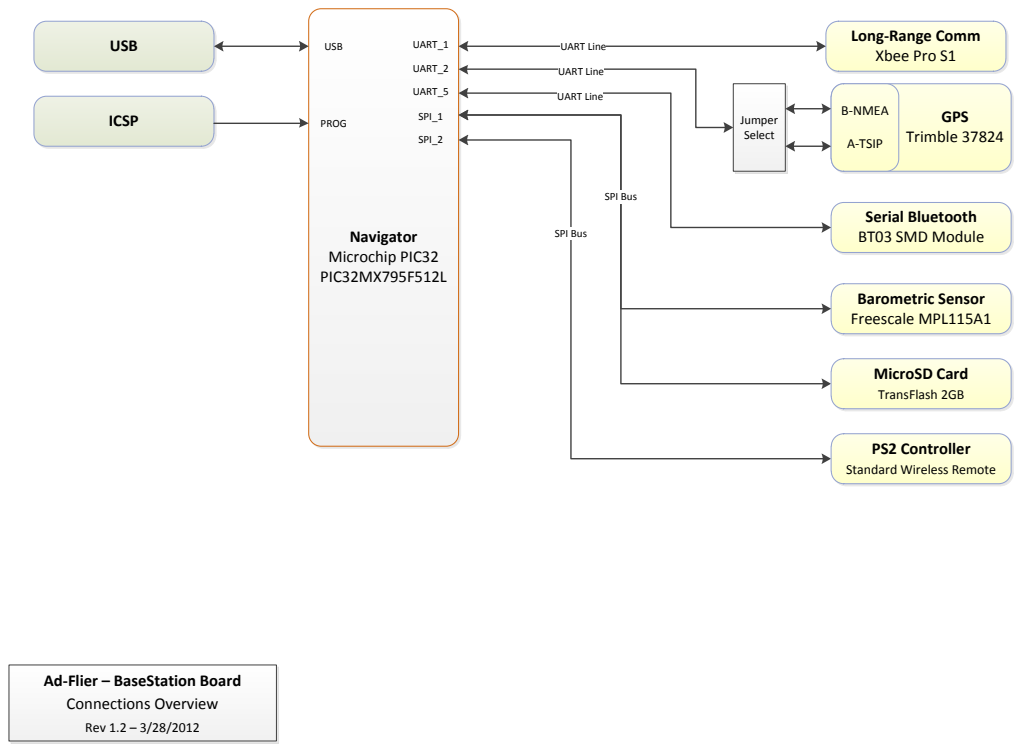
[picture p18: page 2]
Navigator Microchip PIC32 PIC32MX795F512L; USB; ICSP; UART Line; Barometric Sensor Freescale MPL115A1; UART_1; UART_2; UART_5; SPI_1; SPI_2; PROG; GPS; Trimble 37824; B-NMEA; A-TSIP; Serial Bluetooth BT03 SMD Module; Jumper Select; MicroSD Card; TransFlash 2GB

Long-Range Comm
Xbee Pro S1

SPI Bus

PS2 Controller
Standard Wireless Remote

Ad-Flier – BaseStation Board
Connections Overview

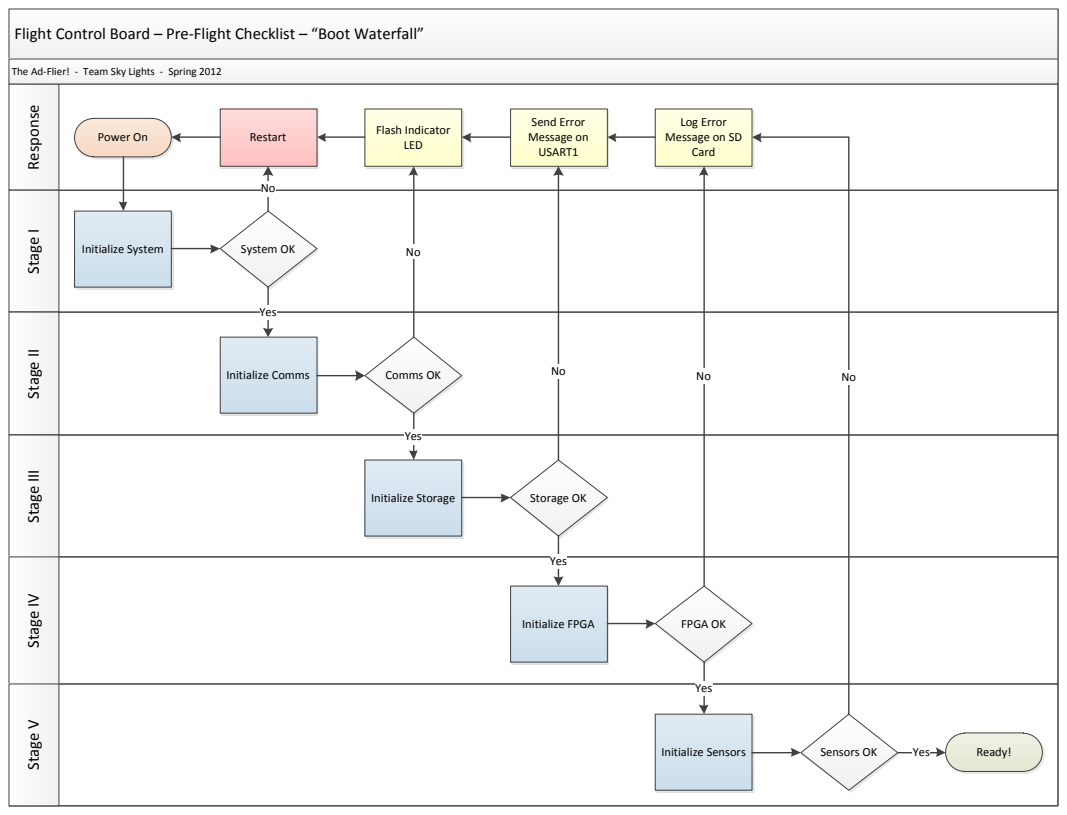
[picture p19: page 3]
esp; nse; Stag; e I Stag; e II Stag; e III Stag; Power On; Initialize System; System OK; Initialize Comms; Yes; Comms OK; Initialize Storage; Storage OK; Initialize FPGA; FPGA OK; Initialize Sensors; Sensors OK; Ready!; Restart; Log Error Message on SD; Card

Flight Control Board – Pre-Flight Checklist – “Boot Waterfall”

The Ad-Flier! - Team Sky Lights - Spring 2012

Send Error Message on USART1

Flash Indicator LED

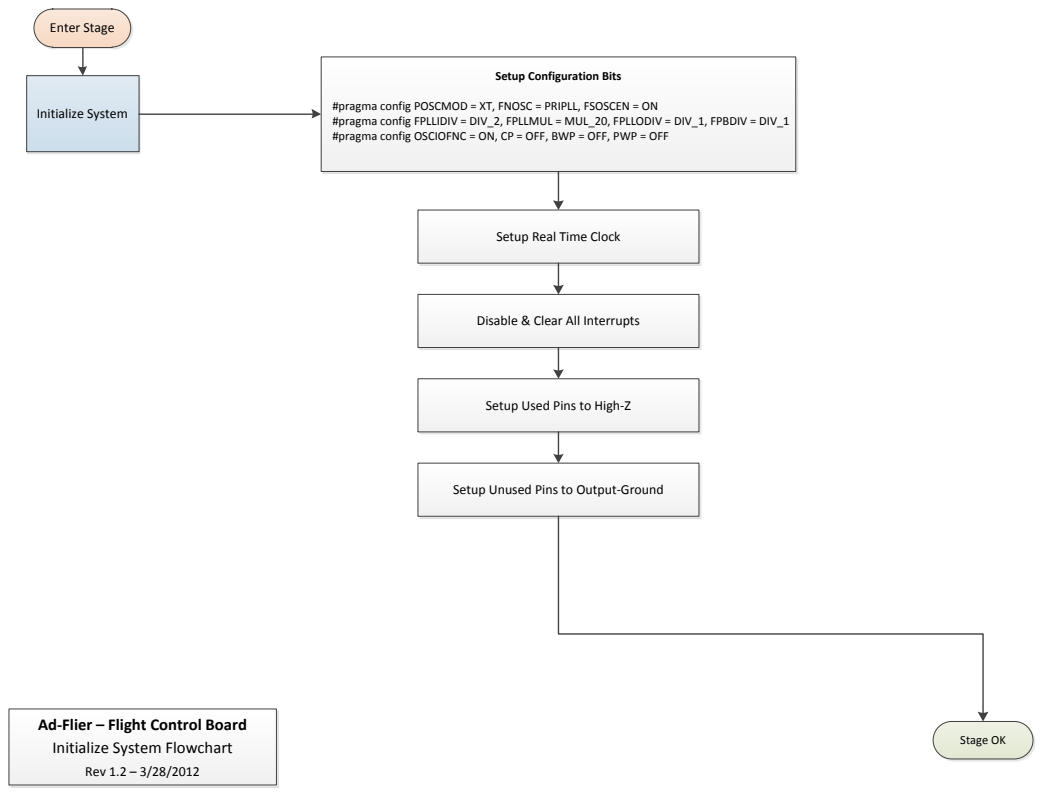
[picture p20: page 4]
Initialize System; Enter Stage; Stage OK

Setup Configuration Bits #pragma config POSCMOD = XT, FNOSC = PRIPLL, FSOSCEN = ON

#pragma config FPLLIDIV = DIV_2, FPLLMUL = MUL_20, FPLLODIV = DIV_1, FPBDIV = DIV_1
#pragma config OSCIOFNC = ON, CP = OFF, BWP = OFF, PWP = OFF

Setup Real Time Clock

Disable & Clear All Interrupts

Setup Used Pins to High-Z

Setup Unused Pins to Output-Ground

Ad-Flier – Flight Control Board
Initialize System Flowchart

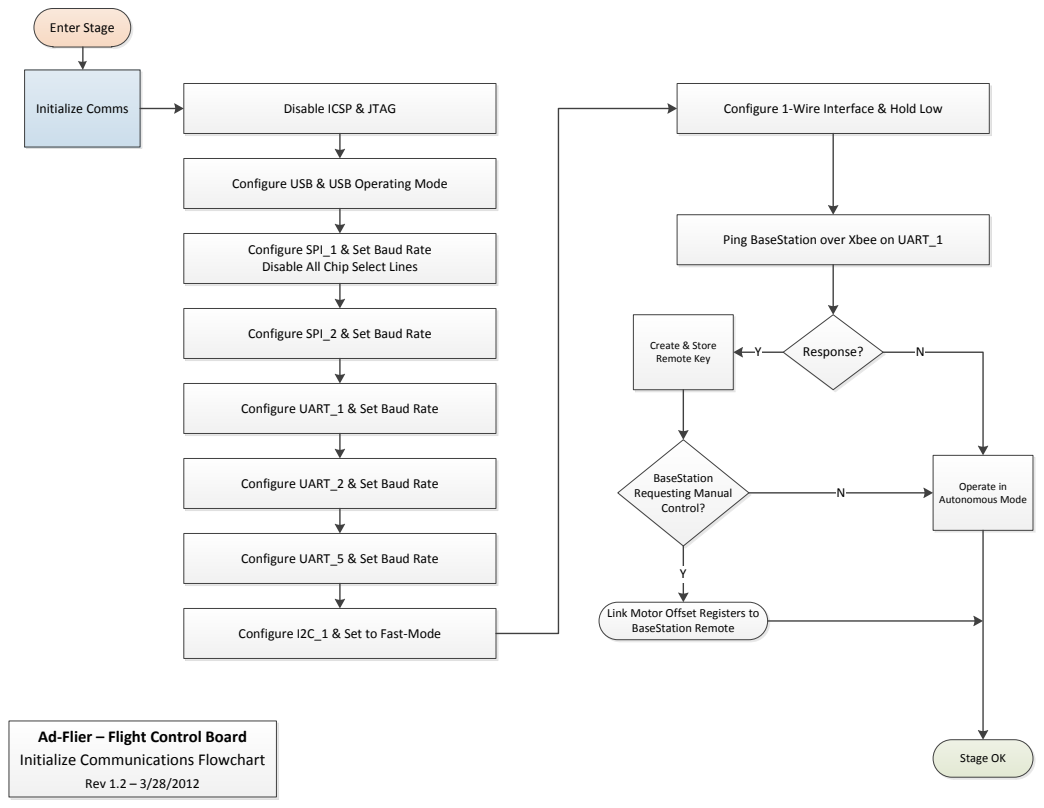
[picture p21: page 5]
Initialize Comms; Enter Stage; Control?

Disable ICSP & JTAG

Configure 1-Wire Interface & Hold Low

Configure USB & USB Operating Mode

Ping BaseStation over Xbee on UART_1

Configure SPI_1 & Set Baud Rate
Disable All Chip Select Lines

Configure SPI_2 & Set Baud Rate

Response? Create & Store Remote Key

Configure UART_1 & Set Baud Rate

BaseStation Requesting Manual

Configure UART_2 & Set Baud Rate

Operate in Autonomous Mode

Configure UART_5 & Set Baud Rate

Link Motor Offset Registers to BaseStation Remote

Configure I2C_1 & Set to Fast-Mode

Ad-Flier – Flight Control Board
Initialize Communications Flowchart

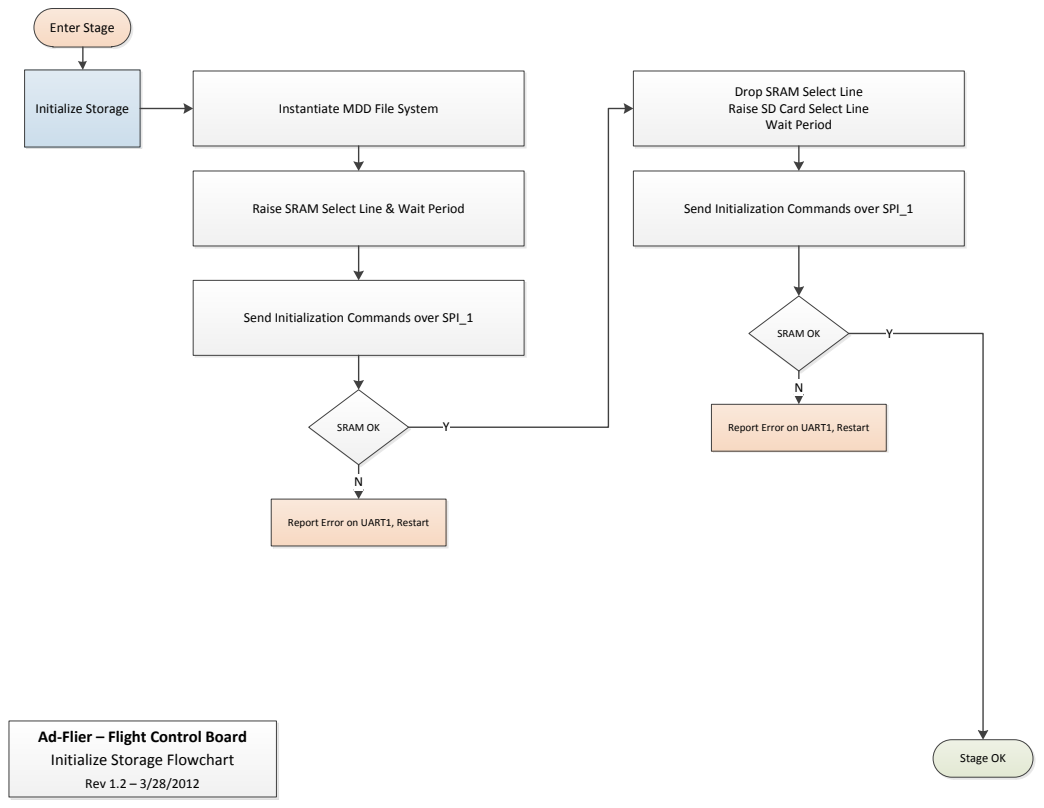
[picture p22: page 6]
Initialize Storage; SRAM OK

Drop SRAM Select Line
Raise SD Card Select Line
Wait Period

Instantiate MDD File System

Raise SRAM Select Line & Wait Period

Send Initialization Commands over SPI_1

Report Error on UART1, Restart

Ad-Flier – Flight Control Board
Initialize Storage Flowchart

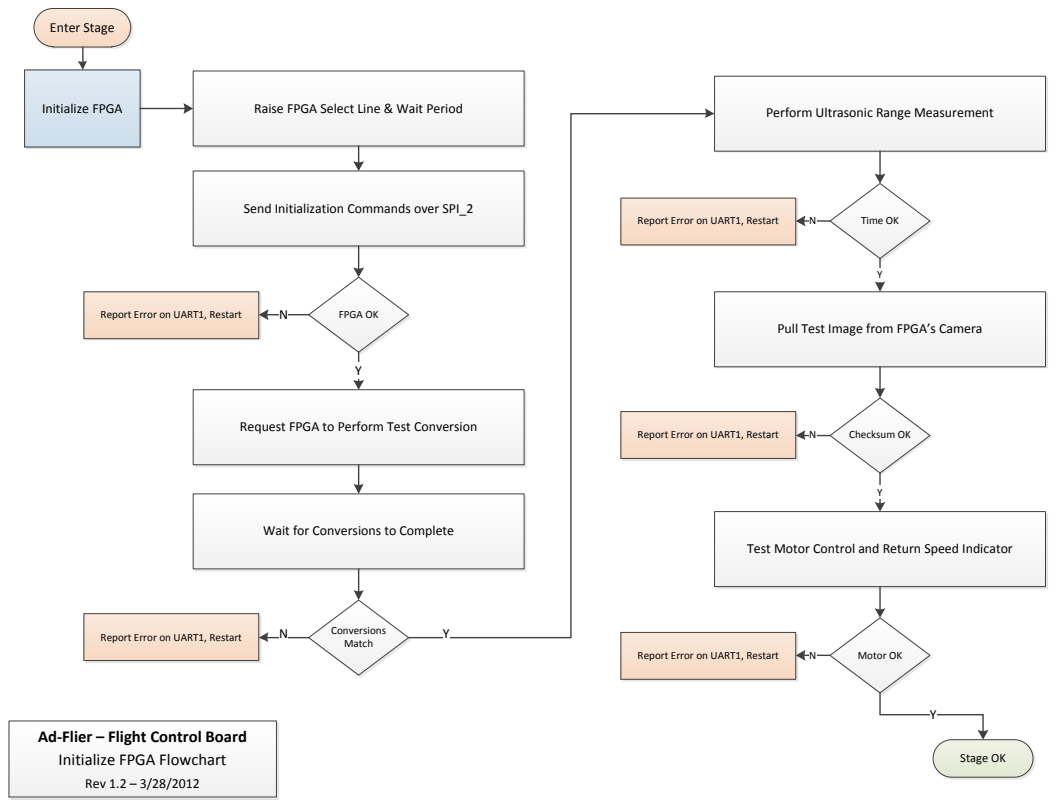
[picture p23: page 7]
Initialize FPGA; Report Error on UART1, Restart; FPGA OK; Time OK; Conversions Match Report Error on UART1, Restart; Checksum OK; Motor OK

Raise FPGA Select Line & Wait Period

Perform Ultrasonic Range Measurement

Send Initialization Commands over SPI_2

Pull Test Image from FPGA’s Camera

Request FPGA to Perform Test Conversion

Wait for Conversions to Complete

Test Motor Control and Return Speed Indicator

Ad-Flier – Flight Control Board
Initialize FPGA Flowchart

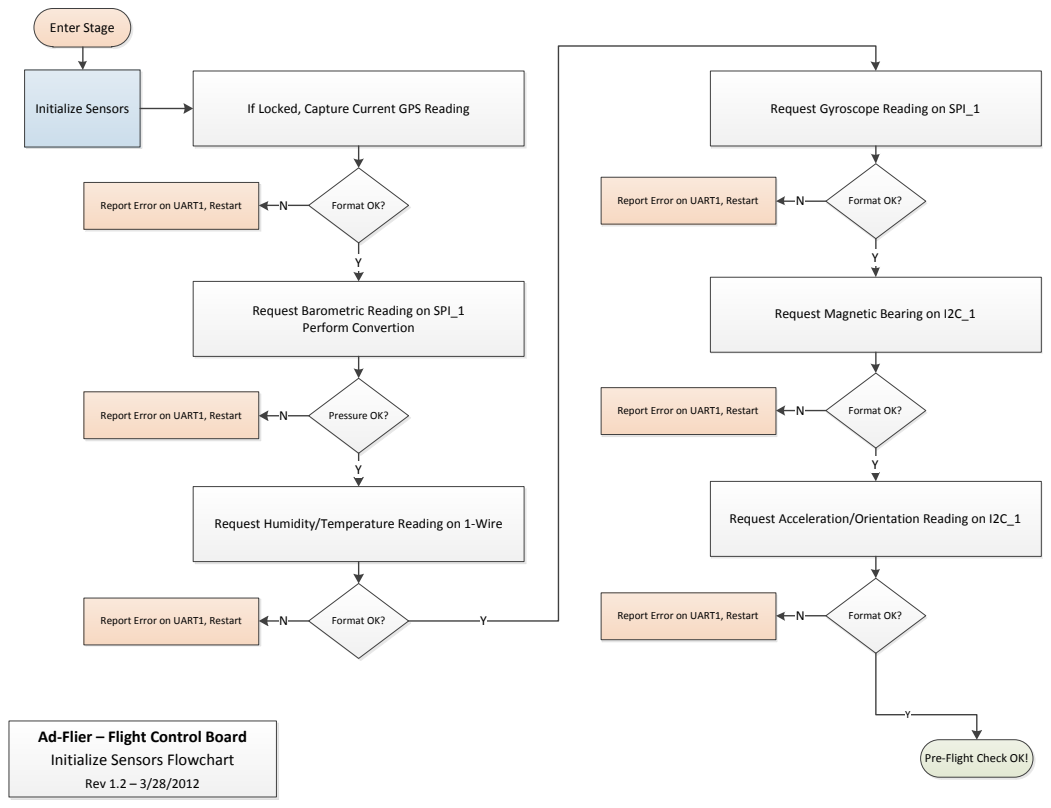
[picture p24: page 8]
Initialize Sensors; Report Error on UART1, Restart; Format OK?; Perform Convertion; Pressure OK?

If Locked, Capture Current GPS Reading

Request Gyroscope Reading on SPI_1

Request Barometric Reading on SPI_1

Request Magnetic Bearing on I2C_1

Request Humidity/Temperature Reading on 1-Wire

Request Acceleration/Orientation Reading on I2C_1

Ad-Flier – Flight Control Board
Initialize Sensors Flowchart

Pre-Flight Check OK!
