Djgreene730/Ad-Flier/altium/project_files/BaseStation/BaseStation.pdf

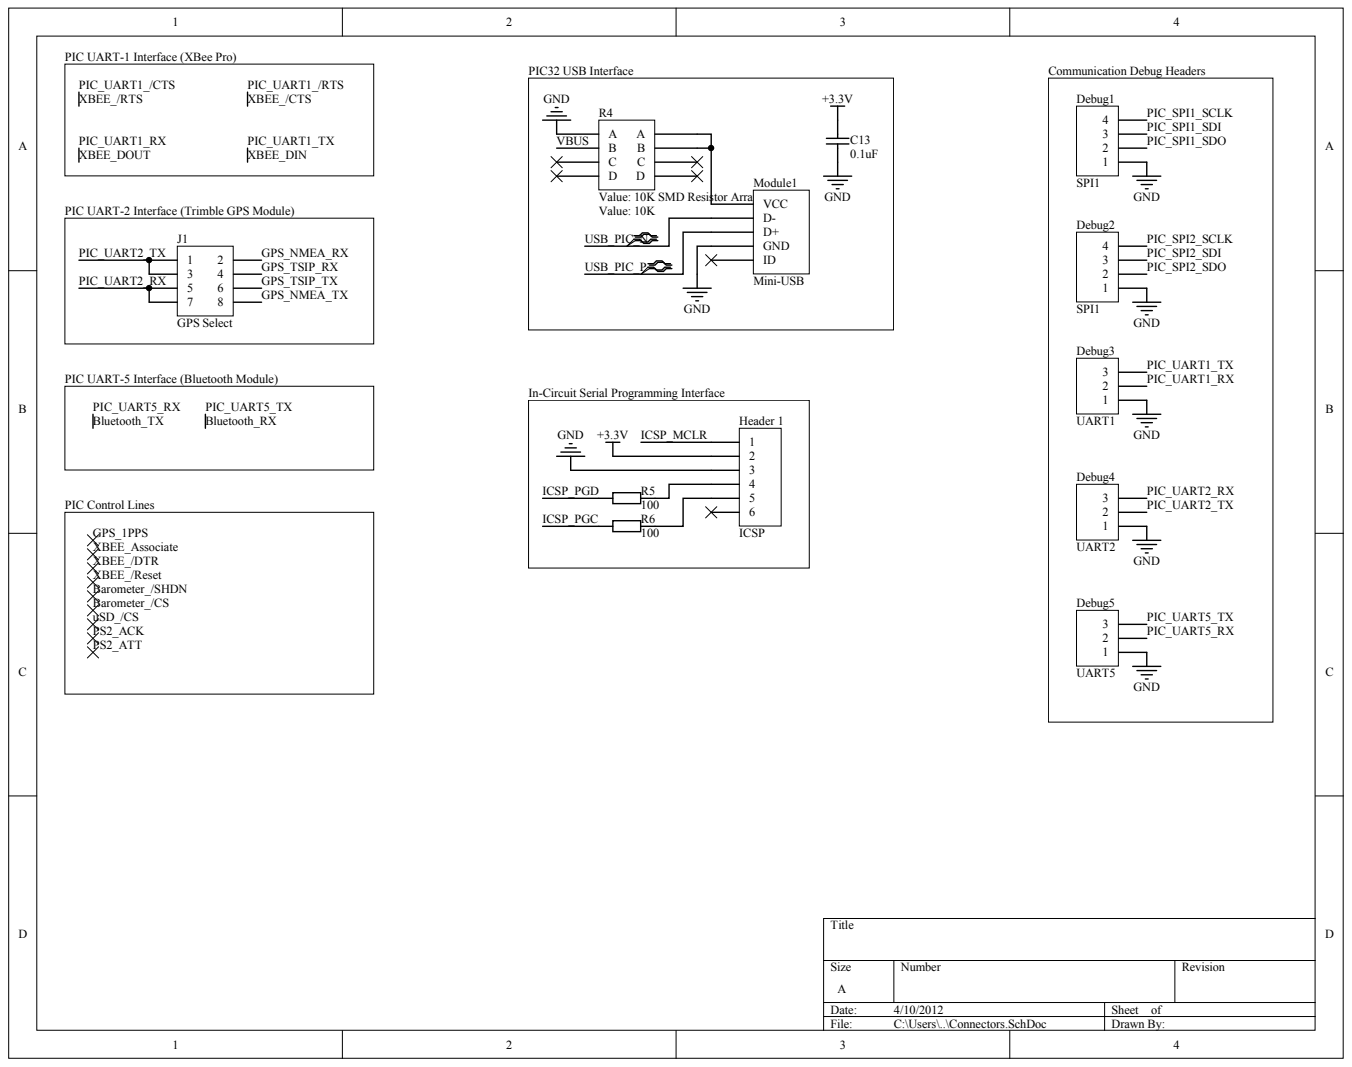
[picture p25: page 1]

PIC UART-1 Interface (XBee Pro

Value: 10K SMD Resistor Array

PIC UART-2 Interface (Trim

PIC UART-5 Interface (Bluetooth Module)

In-Circuit Serial Programm

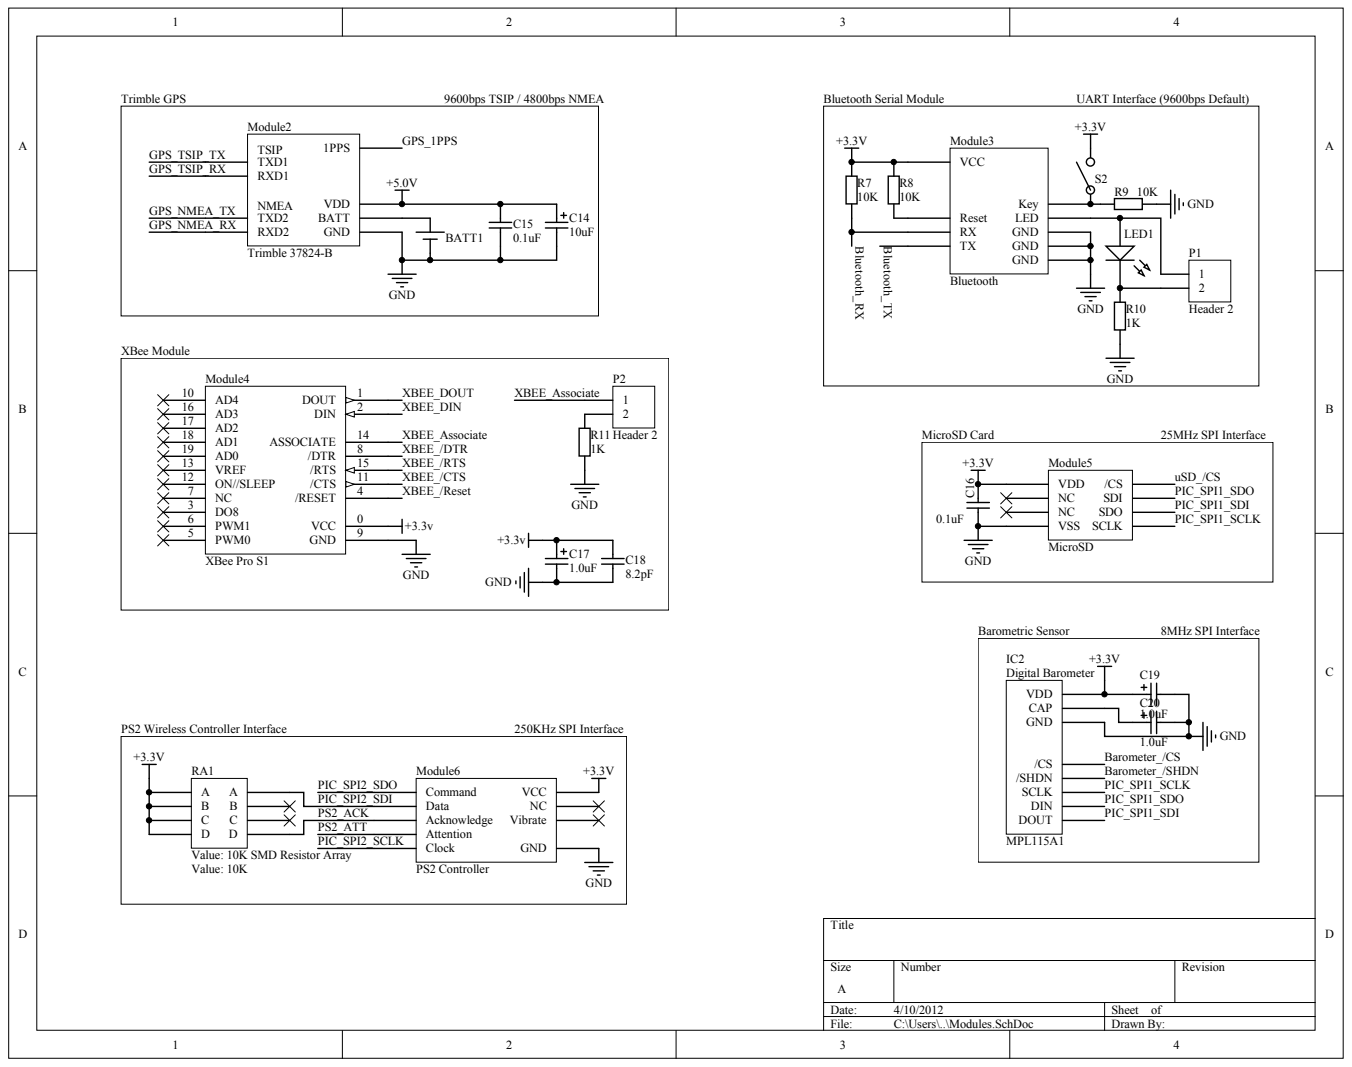
[picture p26: page 2]

PIC_SPI2_SDI

Value: 10K SMD Resistor Array
Value: 10K

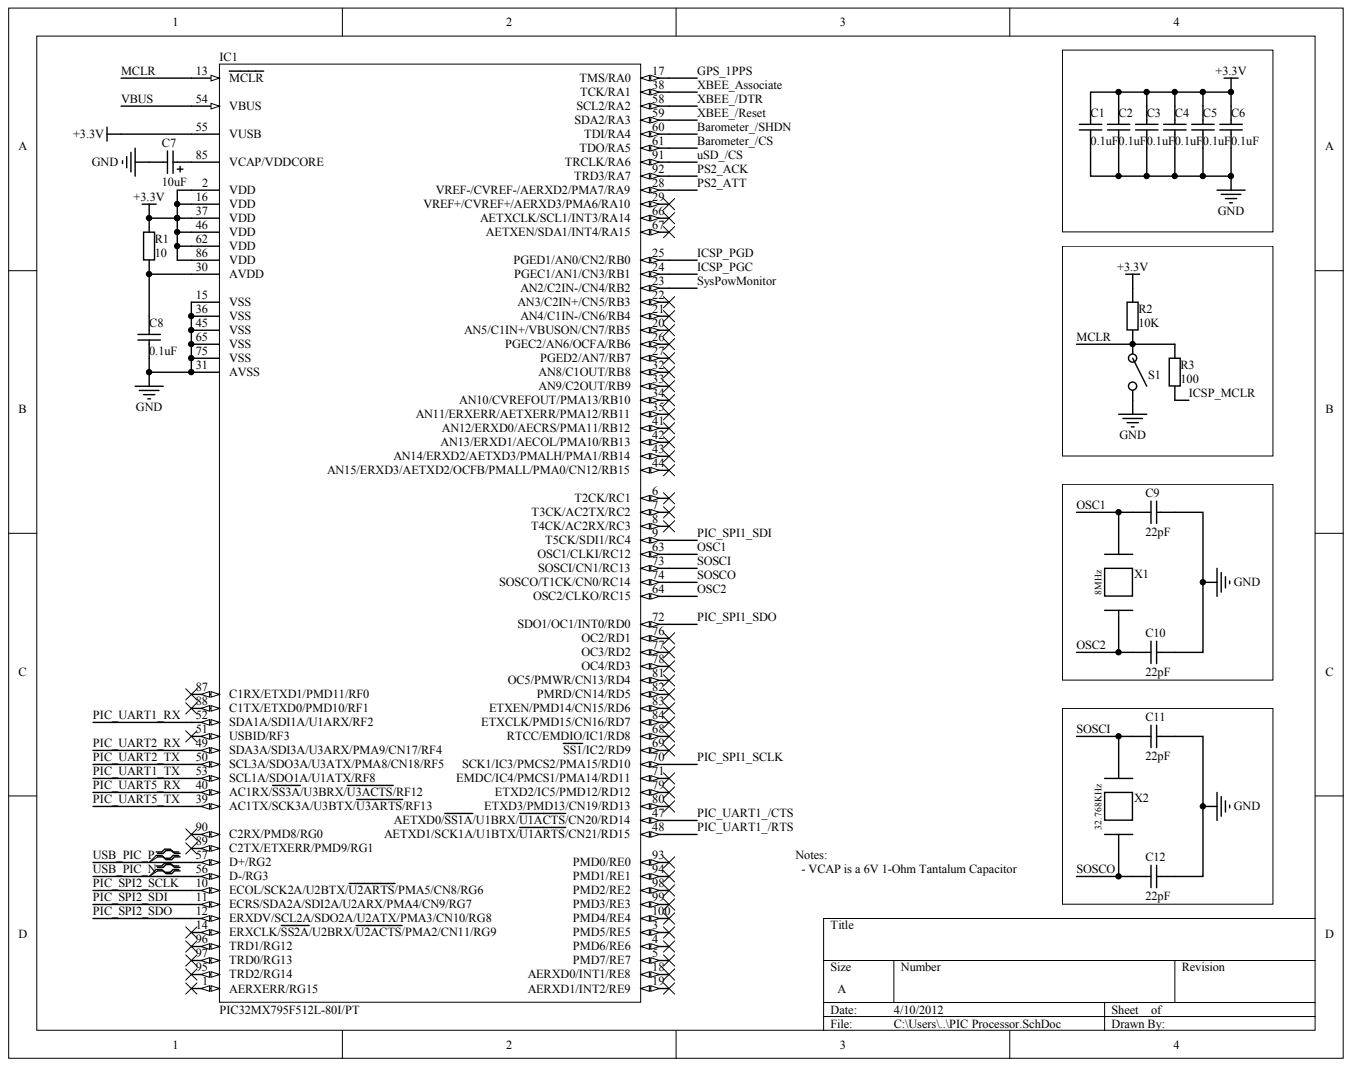
[picture p27: page 3]

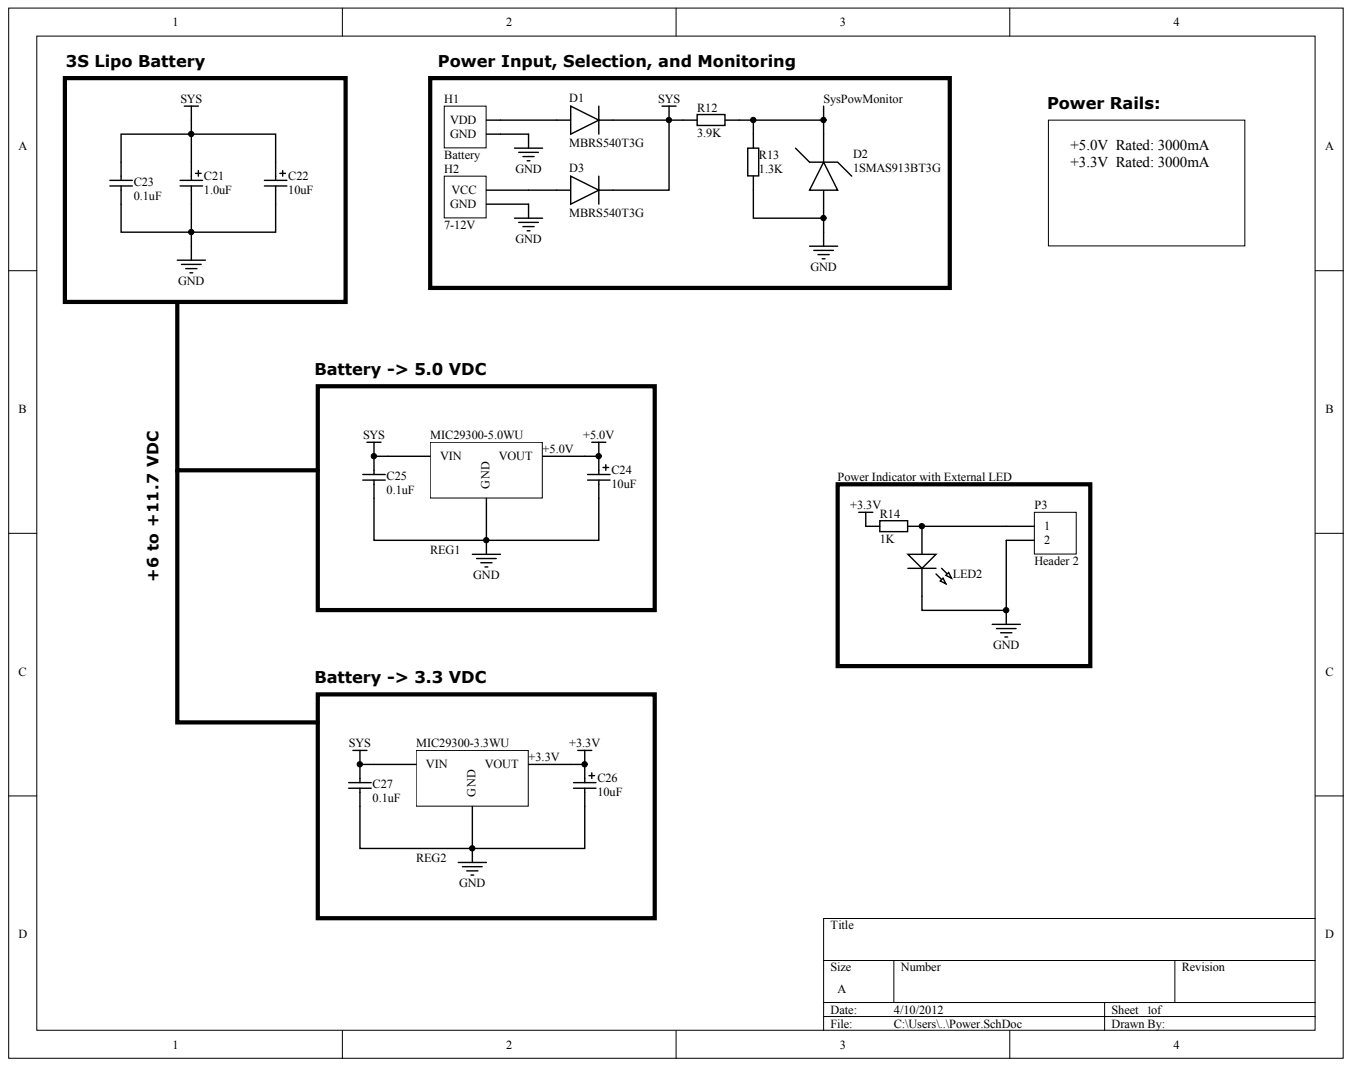
[picture p28: page 4]

Power Input, Selection, and Monitoring

Power Indicator with External LED
