Djgreene730/Ad-Flier/(list of files, drawings)

Other design files:
altium/project_files/Ad-Flier.PrjPcb
altium/project_files/Ad-Flier_Footprints.PcbLib
altium/project_files/Ad-Flier_Parts.SchLib
altium/project_files/BaseStation/Basestation.PcbDoc
altium/project_files/BaseStation/BaseStation.PrjPCB
altium/project_files/BaseStation/Basestation_Backup.PcbDoc
altium/project_files/BaseStation/Connectors.SchDoc
altium/project_files/BaseStation/Modules.SchDoc
altium/project_files/BaseStation/PIC Processor.SchDoc
altium/project_files/BaseStation/Power.SchDoc
altium/project_files/Bottom_Board.SchDoc
altium/project_files/Busses.SchDoc
altium/project_files/FlightController_Bottom.PcbDoc
altium/project_files/FlightController_Bottom.PrjPcb
altium/project_files/FlightController_Top.PcbDoc
altium/project_files/FlightController_Top_5x5.PcbDoc
altium/project_files/FlightController_Top_6x6.PcbDoc
altium/project_files/FPGA_Clocks.SchDoc
altium/project_files/FPGA_Components.SchDoc
altium/project_files/FPGA_Core.SchDoc
altium/project_files/FPGA_Power.SchDoc
altium/project_files/FPGA_Sensors.SchDoc
altium/project_files/Micrel Parts.SchLib
altium/project_files/Navigator_Components.SchDoc
altium/project_files/Navigator_Connectors.SchDoc
altium/project_files/Navigator_Core.SchDoc
altium/project_files/Navigator_Sensors.SchDoc
altium/project_files/Pic32Footprints.PcbDoc
altium/project_files/Power.SchDoc
altium/project_files/TempBoard.PcbDoc
