Djgreene730/Ad-Flier/PIC32_BaseStation.X/RTCC.h

/*
 *  The Ad-Flier! - Gyroscope Include File
 *  Team SkyLights, Senior Design, Spring 2012
 *
 *  Include into Main File for Operability:
 *  #include <Gyroscope.h>
 *
 */

#include <GenericTypeDefs.h>
#include <plib.h>
#include <p32xxxx.h>

extern int CheckRtccRunning( int );
extern int initializeRTCC ( void );
