Djgreene730/Ad-Flier/code_cyclone2/BoardTest/db/BoardTest.smp_dump.txt

State Machine - |BoardTest|regmap:U_Registers|reg_controller:RegCont|state
Name state.wd2 state.wd1 state.wa2 state.wa1 state.rd2 state.rd1 state.ra2 state.ra1 state.fetch 
state.fetch 0 0 0 0 0 0 0 0 0 
state.ra1 0 0 0 0 0 0 0 1 1 
state.ra2 0 0 0 0 0 0 1 0 1 
state.rd1 0 0 0 0 0 1 0 0 1 
state.rd2 0 0 0 0 1 0 0 0 1 
state.wa1 0 0 0 1 0 0 0 0 1 
state.wa2 0 0 1 0 0 0 0 0 1 
state.wd1 0 1 0 0 0 0 0 0 1 
state.wd2 1 0 0 0 0 0 0 0 1 
