Djgreene730/Ad-Flier/(commit log)

2012-02-20 new file: flowcharts/README
2012-02-21 new file: altium/project_files/Ad-Flier.PrjPcb new file: altium/project_files/Navigator_1.SchDoc new file: altium/repository/README.txt new file: altium/repository/conf/authz new file: altium/reposit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
    [Ad-Flier.PrjPcb, Navigator_1.SchDoc]
2012-02-21 new file: code_pic32_flightBoard/Test/FSconfig.h new file: code_pic32_flightBoard/Test/GenericTypeDefs.h new file: code_pic32_flightBoard/Test/Gentium.ttf new file: code_pic32_flightBoard/Test/Graphi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
2012-02-21 new file: altium/parts/Altera ACEX 1K.IntLib new file: altium/parts/Altera APEX 20K.IntLib new file: altium/parts/Altera APEX 20KC.IntLib new file: altium/parts/Altera APEX 20KE.IntLib new file: alti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
    [Ad-Flier.PrjPcb, Busses.SchDoc, FPGA_Core.SchDoc, FPGA_Sensors.SchDoc, Navigator_1.SchDoc, Navigator_Core.SchDoc, Navigator_Sensors.SchDoc, Power.SchDoc]
2012-02-22 new file: flowcharts/Overview-InProgress.vsd
2012-02-22 modified: flowcharts/Overview-InProgress.vsd new file: flowcharts/Overview-InProgress.vsd.pdf
2012-02-28 modified: altium/project_files/Ad-Flier.PrjPcb new file: altium/project_files/Ad-Flier_Parts.SchLib new file: altium/project_files/FPGA_Components.SchDoc modified: altium/project_files/FPGA_Core.SchD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
    [Ad-Flier.PrjPcb, Ad-Flier_Parts.SchLib, FPGA_Components.SchDoc, FPGA_Core.SchDoc, FPGA_Sensors.SchDoc, Navigator_Components.SchDoc, Navigator_Connectors.SchDoc, Navigator_Core.SchDoc]
2012-03-05 deleted: altium/project_files/History/Navigator_Core.~(2).SchDoc.Zip new file: altium/project_files/History/Navigator_Core.~(6).SchDoc.Zip modified: altium/project_files/Navigator_Core.SchDoc
    [Navigator_Core.SchDoc]
2012-03-12 new file: altium/parts/Microchip Microcontroller 32-Bit PIC32.IntLib modified: altium/project_files/Ad-Flier.PrjPcb new file: altium/project_files/Ad-Flier.PrjPcbStructure modified: altium/project_fi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
    [Ad-Flier.PrjPcb, Ad-Flier_Parts.SchLib, FPGA_Core.SchDoc, Micrel Parts.SchLib, Navigator_Connectors.SchDoc, Navigator_Core.SchDoc, Power.SchDoc]
2012-03-13 modified: altium/project_files/Ad-Flier.PrjPcb modified: altium/project_files/Ad-Flier_Parts.SchLib modified: altium/project_files/Busses.SchDoc new file: altium/project_files/History/Ad-Flier.~(15).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
    [Ad-Flier.PrjPcb, Ad-Flier_Parts.SchLib, Busses.SchDoc, Navigator_Connectors.SchDoc, Navigator_Core.SchDoc, Power.SchDoc]
2012-03-19 modified: altium/project_files/Ad-Flier.PrjPcb modified: altium/project_files/Ad-Flier.PrjPcbStructure modified: altium/project_files/Ad-Flier_Parts.SchLib new file: altium/project_files/FPGA_Clocks.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
    [Ad-Flier.PrjPcb, Ad-Flier_Parts.SchLib, FPGA_Clocks.SchDoc, FPGA_Core.SchDoc, FPGA_Power.SchDoc, Navigator_Core.SchDoc, Power.SchDoc]
2012-03-25 new file: altium/parts/History/Ad-Flier_Footprints.~(1).PcbLib.Zip new file: altium/parts/History/Ad-Flier_Footprints.~(10).PcbLib.Zip new file: altium/parts/History/Ad-Flier_Footprints.~(11).PcbLib.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
    [Ad-Flier.PrjPcb, Ad-Flier_Footprints.PcbLib, Ad-Flier_Parts.SchLib, BottomBoard.PcbDoc, Bottom_Board.PcbDoc, Bottom_Board.SchDoc, Busses.SchDoc, ComponentTestBoard.PcbDoc]
2012-04-03 new file: altium/images/Accelerometer.jpg new file: altium/images/Flight_Controller_Bottom_Bottom.png new file: altium/images/Flight_Controller_Bottom_Top.png new file: altium/images/Flight_Controlle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
    [Ad-Flier.PrjPcb, Ad-Flier_Footprints.PcbLib, Ad-Flier_Parts.SchLib, BOM_FlightController_Bottom.xlsx, BaseStation.PrjPCB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]
2012-04-03 modified: altium/project_files/Ad-Flier.PrjPcb modified: altium/project_files/Ad-Flier.pdf modified: altium/project_files/BaseStation/BaseStation.PrjPCB modified: altium/project_files/BaseStation/Bas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
    [Ad-Flier.PrjPcb, BaseStation.PrjPCB, Bottom_Board.SchDoc, FlightController_Bottom.PrjPcb, FlightController_Top_6x6.PcbDoc]
2012-04-07 modified: altium/project_files/BaseStation/BaseStation.PrjPCB modified: altium/project_files/BaseStation/Basestation.PcbDoc deleted: altium/project_files/BaseStation/History/BaseStation.~(2).PrjPCB.Z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
    [BaseStation.PrjPCB, BaseStation.xlsx, Basestation.PcbDoc]
2012-04-09 new file: code_cyclone2/BoardTest/BoardTest.asm.rpt new file: code_cyclone2/BoardTest/BoardTest.cdf new file: code_cyclone2/BoardTest/BoardTest.done new file: code_cyclone2/BoardTest/BoardTest.eda.rp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
2012-04-09 modified: code_cyclone2/BoardTest/BoardTest.qsf new file: code_cyclone2/BoardTest/SPI_Slave.vhd new file: code_cyclone2/BoardTest/SPI_Slave.vhd.bak deleted: code_cyclone2/BoardTest/db/BoardTest.tmw_i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
2012-04-10 modified: altium/project_files/Project Outputs for Ad-Flier/Status Report.Txt modified: code_cyclone2/BoardTest/BoardTest.done modified: code_cyclone2/BoardTest/BoardTest.flow.rpt modified: code_cycl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
2012-04-11 modified: altium/project_files/Ad-Flier.pdf modified: altium/project_files/BaseStation/BaseStation.pdf new file: altium/project_files/FlightController_Bottom.pdf modified: code_cyclone2/BoardTest/Boa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
2012-04-11 modified: code_cyclone2/BoardTest/BoardTest.vhd modified: code_cyclone2/BoardTest/BoardTest.vhd.bak
2012-04-11 modified: altium/project_files/BaseStation/Basestation.PcbDoc renamed: altium/project_files/BaseStation/History/Basestation.~(10).PcbDoc.Zip -> altium/project_files/BaseStation/History/Basestation.~(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
    [Basestation.PcbDoc]
2012-04-12 modified: code_cyclone2/BoardTest/BoardTest.asm.rpt modified: code_cyclone2/BoardTest/BoardTest.done modified: code_cyclone2/BoardTest/BoardTest.eda.rpt modified: code_cyclone2/BoardTest/BoardTest.fi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
2012-04-12 deleted: code_cyclone2/BoardTest/BoardTest.asm.rpt deleted: code_cyclone2/BoardTest/BoardTest.cdf deleted: code_cyclone2/BoardTest/BoardTest.done deleted: code_cyclone2/BoardTest/BoardTest.dpf delete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
2012-04-12 new file: code_cyclone2/BoardTest/BoardTest.asm.rpt new file: code_cyclone2/BoardTest/BoardTest.cdf new file: code_cyclone2/BoardTest/BoardTest.done new file: code_cyclone2/BoardTest/BoardTest.dpf ne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
2012-04-14 deleted: code_cyclone2/BoardTest/BoardTest.dpf# modified: code_cyclone2/BoardTest/BoardTest.qsf new file: code_cyclone2/BoardTest/BoardTest_assignment_defaults.qdf deleted: code_cyclone2/BoardTest/db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
2012-04-14 modified: code_cyclone2/BoardTest/BoardTest.asm.rpt modified: code_cyclone2/BoardTest/BoardTest.cdf modified: code_cyclone2/BoardTest/BoardTest.done modified: code_cyclone2/BoardTest/BoardTest.eda.rp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
2012-04-15 new file: code_pic32_baseStation/BoardTest/Ad-Flier_BaseStation/Communications.c new file: code_pic32_baseStation/BoardTest/Ad-Flier_BaseStation/Communications.h modified: code_pic32_baseStation/Boar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
2012-04-15 modified: code_cyclone2/BoardTest/BoardTest.asm.rpt modified: code_cyclone2/BoardTest/BoardTest.done modified: code_cyclone2/BoardTest/BoardTest.eda.rpt modified: code_cyclone2/BoardTest/BoardTest.fi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
    [BoardTest.smp_dump.txt]
2012-04-15 modified: code_cyclone2/BoardTest/BoardTest.done modified: code_cyclone2/BoardTest/BoardTest.flow.rpt modified: code_cyclone2/BoardTest/BoardTest.map.rpt modified: code_cyclone2/BoardTest/BoardTest.m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
2012-04-15 modified: code_cyclone2/BoardTest/BoardTest.asm.rpt modified: code_cyclone2/BoardTest/BoardTest.done modified: code_cyclone2/BoardTest/BoardTest.eda.rpt modified: code_cyclone2/BoardTest/BoardTest.fi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
2012-04-16 modified: PIC32_FlightController.X/Communications.c new file: PIC32_FlightController.X/Gyroscope.c new file: PIC32_FlightController.X/Gyroscope.h modified: PIC32_FlightController.X/Main.c modified: P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
2012-04-18 new file: PIC32_BaseStation.X/Ad-Flier_Pins.c new file: PIC32_BaseStation.X/Ad-Flier_Pins.h new file: PIC32_BaseStation.X/Communications.c new file: PIC32_BaseStation.X/Communications.h renamed: PIC3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
2012-04-19 modified: code_cyclone2/BoardTest/BoardTest.asm.rpt modified: code_cyclone2/BoardTest/BoardTest.done modified: code_cyclone2/BoardTest/BoardTest.eda.rpt modified: code_cyclone2/BoardTest/BoardTest.fi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
2012-04-19 modified: PIC32_BaseStation.X/Main.c new file: PIC32_FlightController.X/Accelerometer.c new file: PIC32_FlightController.X/Accelerometer.h modified: PIC32_FlightController.X/Ad-Flier_Pins.c modified: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
2012-04-19 modified: code_cyclone2/BoardTest/BoardTest.asm.rpt modified: code_cyclone2/BoardTest/BoardTest.done modified: code_cyclone2/BoardTest/BoardTest.eda.rpt modified: code_cyclone2/BoardTest/BoardTest.fi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
2012-04-19 modified: code_cyclone2/BoardTest/BoardTest.asm.rpt modified: code_cyclone2/BoardTest/BoardTest.cdf modified: code_cyclone2/BoardTest/BoardTest.done modified: code_cyclone2/BoardTest/BoardTest.eda.rp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
    [BoardTest.smp_dump.txt]
2012-04-19 modified: code_cyclone2/BoardTest/BoardTest.asm.rpt modified: code_cyclone2/BoardTest/BoardTest.done modified: code_cyclone2/BoardTest/BoardTest.eda.rpt modified: code_cyclone2/BoardTest/BoardTest.fi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
2012-04-19 modified: PIC32_BaseStation.X/Communications.c modified: PIC32_BaseStation.X/Communications.h modified: PIC32_BaseStation.X/Main.c modified: PIC32_BaseStation.X/build/default/production/Communication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
    [BoardTest.smp_dump.txt]
2012-04-23 modified: code_cyclone2/BoardTest/BoardTest.qsf modified: code_cyclone2/BoardTest/BoardTest.vhd new file: code_cyclone2/BoardTest/db/BoardTest.db_info new file: code_cyclone2/BoardTest/db/BoardTest.s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
2012-04-23 modified: PIC32_BaseStation.X/Communications.c modified: PIC32_BaseStation.X/Main.c new file: PIC32_BaseStation.X/build/default/debug/Ad-Flier_Pins.o new file: PIC32_BaseStation.X/build/default/debug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
    [BoardTest.smp_dump.txt]
2012-04-23 modified: code_cyclone2/BoardTest/BoardTest.qsf modified: code_cyclone2/BoardTest/BoardTest.vhd deleted: code_cyclone2/BoardTest/db/BoardTest.(0).cnf.cdb deleted: code_cyclone2/BoardTest/db/BoardTest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
    [BoardTest.smp_dump.txt]
2012-04-23 modified: PIC32_FlightController.X/Main.c modified: PIC32_FlightController.X/Orientation.c modified: PIC32_FlightController.X/Orientation.h modified: PIC32_FlightController.X/build/default/debug/Main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
    [BoardTest.smp_dump.txt]
2012-04-24 modified: PIC32_BaseStation.X/Main.c deleted: PIC32_BaseStation.X/build/default/debug/Ad-Flier_Pins.o deleted: PIC32_BaseStation.X/build/default/debug/Ad-Flier_Pins.o.d deleted: PIC32_BaseStation.X/b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
2012-04-24 deleted: code_cyclone2/BoardTest/.qsys_edit/filters.xml deleted: code_cyclone2/BoardTest/.qsys_edit/preferences.xml deleted: code_cyclone2/BoardTest/.sopc_builder/filters.xml deleted: code_cyclone2/B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
    [BoardTest.smp_dump.txt]
2012-04-24 new file: code_cyclone2/BoardTest/.qsys_edit/filters.xml new file: code_cyclone2/BoardTest/.qsys_edit/preferences.xml new file: code_cyclone2/BoardTest/.sopc_builder/filters.xml new file: code_cyclon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
    [BoardTest.smp_dump.txt]
2012-04-24 modified: code_cyclone2/BoardTest/BoardTest.asm.rpt modified: code_cyclone2/BoardTest/BoardTest.cdf modified: code_cyclone2/BoardTest/BoardTest.done modified: code_cyclone2/BoardTest/BoardTest.eda.rp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
2012-04-24 modified: PIC32_BaseStation.X/Communications.h modified: PIC32_BaseStation.X/Main.c new file: PIC32_BaseStation.X/build/default/debug/Ad-Flier_Pins.o new file: PIC32_BaseStation.X/build/default/debug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
2012-04-25 modified: PIC32_BaseStation.X/Communications.c modified: PIC32_BaseStation.X/Communications.h modified: PIC32_BaseStation.X/Main.c modified: PIC32_BaseStation.X/build/default/debug/Communications.o m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
    [BoardTest.smp_dump.txt]
2012-04-28 Changes to be committed: (use "git reset HEAD <file>..." to unstage)
    modified: code_cyclone2/BoardTest/BoardTest.asm.rpt
    modified: code_cyclone2/BoardTest/BoardTest.done
    modified: code_cyclone2/BoardTest/BoardTest.eda.rpt
    modified: code_cyclone2/BoardTest/BoardTest.fit.rpt
    modified: code_cyclone2/BoardTest/BoardTest.fit.summary
    modified: code_cyclone2/BoardTest/BoardTest.flow.rpt
    modified: code_cyclone2/BoardTest/BoardTest.map.rpt
    modified: code_cyclone2/BoardTest/BoardTest.map.summary
    modified: code_cyclone2/BoardTest/BoardTest.pof
    modified: code_cyclone2/BoardTest/BoardTest.sof
    modified: code_cyclone2/BoardTest/BoardTest.sta.rpt
    modified: code_cyclone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
    [BoardTest.smp_dump.txt]
2012-05-01 new file: PIC32_BaseStation.X/PS2_Controller.c new file: PIC32_BaseStation.X/PS2_Controller.h modified: PIC32_BaseStation.X/nbproject/Makefile-default.mk modified: PIC32_BaseStation.X/nbproject/Makef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
2012-05-01 deleted: code_pic32_baseStation/BoardTest/Ad-Flier_BaseStation/Communications.c deleted: code_pic32_baseStation/BoardTest/Ad-Flier_BaseStation/Communications.h deleted: code_pic32_baseStation/BoardTe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
